Dennel04/data-acquisition-course/data-acquisition/lab2/src/README.md

# Labor 2 mõõtmistarkvara

Esimene etapp kogub ainult ADC toorandmeid. Varasema versiooni USB-only üleslaadimine, LCD töö ja `measure_stop` käsu `stopped` vastus on kasutaja kinnitatud (Serial Monitor `--eol LF`). Allpool kirjeldatud AUTO-versioon on kohalik muudatus ja vajab eraldi üleslaadimisluba ning riistvarakatset. Elektriline sobivus, tegelik sagedus ja rõhukalibratsioon vajavad mõõtmist. Labor 1 lähtekood jääb muutmata. Võrguühenduseta CSV analüüs: [notebooks/README.md](../notebooks/README.md).

- 14.11.26 märkus: ühises AtomS3R-is on praegu ajutine G5-mõõtja ([`firmware_g5meter`](firmware_g5meter/src/main.cpp)), mitte `DA2_MEASURE_V1`. Varem seadmes olnud `DA2_MEASURE_V1` salvestati enne üleslaadimist täieliku flash'i koopiana. Enne `logger.py` kasutamist pane `DA2_MEASURE_V1` tagasi. [Üksikasjad](../docs/opamp_rebuild_2026-11-14.md#3-atomi-püsivara-muutus).
- 14.11.26 märkus: ümberehitatud astme kordustest: [`opamp_retest.py`](python/opamp_retest.py), käivitus topeltklõpsuga `run_opamp_retest.bat` / `run_opamp_retest.command`. Töötab nii `DA2_MEASURE_V1` kui G5-mõõtjaga. [Juhend](../docs/opamp_retest.md).

## Mõõtmisrežiim

`firmware/` on AtomS3R PlatformIO projekt (`atoms3r`, ühilduv board `m5stack-atoms3`). GPIO G5 on sisend: 12 bitti, `ADC_11db`, kaheksa lugemi täisarvuline keskmine. Siht on üks proov iga 10 ms järel. Hilinenud ajavahemikud loendatakse, mitte ei täideta väljamõeldud proovidega.

Pärast toite sisselülitamist alustab seade AUTO-režiimis ADC lugemist ka ilma USB monitori või logijata. LCD näitab `AUTO / config unknown`, viimast ADC koodi ja `not calibrated`. LCD ja Serial Monitori eelvaade uuenevad kuni neli korda sekundis; see on kuvamise sagedus, mitte ADC 100 Hz siht. Täis USB-puhvri korral jäetakse eelvaaterida saatmata, ADC lugemine ja LCD jätkavad.

AUTO ei määra `raw/opamp` ühendust ega arvuta pinget või rõhku. Lahtise G5 kood võib ujuda. Automaatkäivitus ei kinnita ühendatud ahela elektrilist ohutust: uus versioon hakkab G5 lugema kohe pärast käivitumist, seega tuleb sisendi ohutus kontrollida enne toite sisselülitamist.

Wi-Fi, võrk, pumbajuhtimine, robot ja salvestatud seadete laadimine puuduvad. NVS-i algatamine ja namespace'ide avamine on linker-guardidega blokeeritud, et Arduino automaatne taastamine ega M5 teegid ei muudaks olemasolevaid seadeid. See ei taga kogu flash'i muutumatust: SDK panic/coredump ja OTA metadata jäävad eraldi riskiks. Ärge kasutage `erase_flash`, `uploadfs` ega tehase lähtestamist. Enne eraldi lubatud üleslaadimist kontrollige olemasoleva püsivara taastamise võimalust ja privaatset backup'i.

`raw` tähendab kontrollitud anduriväljundit, `opamp` kontrollitud astme väljundit. Silt ei muuda juhtmestikku ega kalibratsiooni. Mõlema elektriline sobivus tuleb eraldi kinnitada: [tööjärjekord](../docs/bench_session.md#6-mõõtmisprogrammi-kasutuselevõtt).

## USB protokoll

115200 baud. AUTO-eelvaade on loetav tekstirida prefiksiga `# AUTO `: aeg `t_ms`, ADC kood, `config=unknown`, `calibrated=false` ja vahele jäänud ADC intervallide arv `missed`. See ei ole CSV ega logija mõõtepakett.

Juhtkäsud ja hallatud mõõtepaketid on üks ASCII JSON-objekt real, lõpus LF (`\n`). Logija saadab ühe käivituskäsu koos juhusliku jooksu ID-ga:

```json
{"cmd":"measure_start","config":"raw","run":"0123456789abcdef"}
```

`measure_start` lülitab AUTO välja, alustab uut loendust (`seq=0`, `missed=0`) ning kinnitab `event=started`, `firmware=DA2_MEASURE_V1`, sama `run` ja `config`, `period_ms=10`, `adc_pin=5`, `adc_bits=12`, `adc_samples=8`, `calibrated=false`. Seejärel väljastab ainult hallatud mõõtepakette:

```json
{"t":1234,"adc":123,"p":null,"pump":null,"config":"raw","run":"0123456789abcdef","seq":0,"missed":0}
```

Näide on sünteetiline, mitte mõõtmine. `t` on Atomi `millis()`, `seq` algab nullist, `missed` loendab vahele jäänud 10 ms intervalle. `{"cmd":"measure_stop"}` peatab nii AUTO kui ka hallatud mõõtmise, vastab `{"event":"stopped"}` ning kuvab `STOPPED`. Uus `measure_start` saab alustada uut jooksu. Toite taaskäivitus alustab jälle AUTO-režiimist. Neid käske ei tohi asendada Labor 1 pumbakäskudega. Vigane käsk või serial-raam peatab mõõtmise. USB kadumine peatab hallatud jooksu; taasühendus seda ei taasta. AUTO jätkab ilma USB-ta LCD-l.

Kasuta AUTO-versiooniga selle repo ajakohastatud logijat: enne käivituskinnitust ignoreerib see veel puhvris olevaid AUTO-ridu. Pärast kinnitust kehtib sama range JSON-protokoll ja CSV-skeem; ükski AUTO-rida ei lähe CSV-sse. Ootamatu AUTO-rida käimasoleva jooksu sees on viga, mitte vaikselt eemaldatav proov.

## ADC vaatamine ilma logijata

Pärast eraldi lubatud AUTO-versiooni üleslaadimist piisab LCD jaoks toitest. Serial Monitoris vali 115200 baud ja LF. PlatformIO monitor Windows PowerShellis:

```powershell
pio device monitor --port COM3 --baud 115200 --eol LF --filter send_on_enter --echo
```

macOS-is:

```sh
pio device monitor --port /dev/cu.usbmodem1301 --baud 115200 --eol LF --filter send_on_enter --echo
```

Asenda port tegeliku seadme omaga. `pio` peab olema arvutisse paigaldatud; ka muu 115200 baud / LF Serial Monitor sobib. AUTO-eelvaate nägemiseks pole vaja ühtegi käsku. Peatamiseks saada `{"cmd":"measure_stop"}` ja Enter. Pärast peatamist saab uue hallatud jooksu alustada alloleva logijaga, AUTO taastub toite taaskäivitamisel.

Atom ei loo arvutis CSV-faili. AUTO tekst on vaatamiseks kuni 4 Hz, mitte 100 Hz andmestik analüüsiks. CSV ja jooksu metaandmete salvestamiseks kasuta allolevat Python logijat, sulgedes enne Serial Monitori. Logija valib ühendusele vastava `raw/opamp` sildi ja käivitab hallatud 100 Hz sihiga jooksu. Ka muu arvutiprogramm võiks andmeid salvestada, kuid monitori kopeeritud teksti ei tohi esitada selle logija CSV-na.

## Logija Windowsis ja macOS-is

Sulge Serial Monitor ja kõik teised sama porti kasutavad programmid. Kasuta tegelikult tuvastatud porti, mitte vana pordinumbrit. Järgmised käsud on tulevase füüsilise katse jaoks, mitte selle ettevalmistuse käigus tehtud katsed:

Logija lubab ainult kohalikke porte `COM1`, `COM3`, `COM10` jne (ka väiketähtedega) või macOS-i `/dev/cu.*` nimesid. URL-id ja kaugühendused on keelatud. Windowsis ei anta pyserialile POSIX-i `exclusive` parameetrit; macOS-is säilib `exclusive=True`. DTR ja RTS seatakse enne avamist väärtusele `False`. Vigane või avamatu port ei tekita CSV-d ega `.runs.jsonl` faili; olemasolev CSV säilib.

**Windows PowerShell**, repo juurkataloogist:

```powershell
cd data-acquisition/lab2
py -3 -m venv .venv
.\.venv\Scripts\python.exe -m pip install -r src/python/requirements.txt
```

Leia Atomile määratud COM-number Device Managerist (`Ports (COM & LPT)`). Järgmises käsus asenda `COM3` tegeliku pordiga. Käivita see ainult pärast ühendatud raw-ahela elektrilist kontrolli multimeetriga; `--electrical-check-confirmed` kinnitab seda kontrolli, mitte USB-only testi:

```powershell
.\.venv\Scripts\python.exe src/python/logger.py --port COM3 --config raw --csv data/measurements.csv --condition atmosphere --trial 1 --duration 10 --electrical-check-confirmed
```

**macOS**, repo juurkataloogist; asenda `/dev/cu.usbmodemXXXX` tegeliku pordiga ja kinnita enne mõõtmist sama elektriline kontroll:

```sh
cd data-acquisition/lab2
python3 -m venv .venv
.venv/bin/pip install -r src/python/requirements.txt
.venv/bin/python src/python/logger.py --port /dev/cu.usbmodemXXXX \
  --config raw --csv data/measurements.csv --condition atmosphere \
  --trial 1 --duration 10 --electrical-check-confirmed
```

Püsivas tööpunktis lisa `--dmm-v TEGELIK_PINGE` (asenda mõõdetud arvuga). See on käsitsi sisestatud G5 sõlme võrdluspinge, mitte iga proovi mõõdetud pinge. `dmm_recorded_utc` on logijasse sisestamise aeg; tegelik multimeetri mõõtmisaeg ja meetod märgi töölehele. Ära lisa üht püsipinge näitu muutuva impulsi jooksule.

Järgmise jooksu lisamiseks samasse CSV-sse kasuta `--append`, uut `--trial` numbrit ning õiget `--config raw` või `--config opamp`. Olemasolevat faili ilma `--append` parameetrita ei kirjutata üle. Ühine CSV on lubatud ainult koos iga rea `config`, `run_id`, `condition` ja `trial` väljadega. Füüsiliselt vaheta ühendusi ainult väljalülitatud toitega.

CSV veerud:

```text
t_ms,adc,p_kpa,pump,config,run_id,seq,missed,voltage_v,dmm_reference_v,dmm_recorded_utc,condition,trial,adc_clipped
```

`p_kpa`, `voltage_v` ja `pump` jäävad tühjaks: puuduvad selle seadme ja kummagi konfiguratsiooni kinnitatud teisendus ning pumba tagasiside. Tühi pump ei tähenda `off`. `adc_clipped` märgib ainult koodi 0 või 4095, mitte diagnoosi ega elektrilist ohutust. Kõik jooksud saavad kõrvalfaili `.runs.jsonl`, kus on kestus, ridade arv, sagedus, min/max intervall ja vead. Poolik jooks säilib tõendina; ära kasuta seda vaikimisi kehtiva võrdlusena. Logija lõpetab vigase raami, vale konfiguratsiooni, puuduva proovi või 500 ms vaikuse korral; pumba olekut ta ei muuda. Väljumiskood 0 nõuab lõppenud jooksu, null vahelejäänud intervalli ning 9–11 ms proovivahesid. Tegelik USB läbilase ja 100 Hz tuleb riistvaral kontrollida.

## Tarkvarakontroll

**AUTO kontrolliseis (07.11.2026): software-tested, mitte hardware-verified.** Sünteetilised tarkvaratestid: 43 läbitud, kaks muutmata analüsaatori graafikutesti jäid Matplotlibi puudumisel vahele. Hostil kontrolliti tegelikku C++ mõõtmisloogikat ja firmware loop'i imiteeritud ADC/LCD/USB-ga; `atoms3r` build õnnestus. AUTO-versiooni ei laaditud selle kontrolli käigus seadmesse ega kontrollitud füüsilisel riistvaral. Varasemad mõõtmisprotokollid ei kinnita selle AUTO-versiooni riistvarakatset.

```sh
python3 -m unittest discover -s data-acquisition/lab2/tests -v
cd data-acquisition/lab2/src/firmware
pio run -e atoms3r
```

Testid kasutavad sünteetilisi JSON-ridu, ajakella ja ajutisi CSV-faile; ühestki testist ei saa füüsilisi mõõtetulemusi. Hostil kompileeritakse ka tegelik C++ ajastusloogika. Üleslaadimine vajab eraldi luba.

## Labor 1 lähtejoon ja veel vajalik kalibratsioon

- Toetada kahte selgelt valitavat konfiguratsiooni: `raw` ja `opamp`.
- Hoida konfiguratsiooniga seotud ADC ja teisenduse seaded eraldi ning jälgitavad.
- Võtta raw-konfiguratsiooni lähtepunktiks Labori 1 MPX5700AP ülekandefunktsioon `Vout = Vcc · (0,0012858 · P_abs + 0,04)`, 12-bitine ADC, `ADC_11db`, kaheksa lugemi keskmine ja empiiriline koodist pingeks tegur `3,70 V / 4095`. Allikad: `data-acquisition/lab1/src/firmware/include/sensor.h`, `data-acquisition/lab1/src/firmware/src/sensor.cpp` ja `data-acquisition/lab1/docs/sensor_choice.md`. Kontrollida tegur Labor 2 riistvaral uuesti: TODO: real measurement required.
- Säilitada ametliku Labor 2 sisendi diskreetimise siht `100 Hz`. Laboris 1 mõõdeti `1002` rida `10010 ms` jooksul ehk ligikaudu `100,1 Hz`; Labor 2 tegelik sagedus: TODO: real measurement required.
- Kuvada konfiguratsioon nii, et logi ja ekraani olek ei läheks segamini.

## Python logger

- Lisada Labori 1 CSV-skeemile `t_ms,adc,p_kpa,pump` veerg `config`, mille lubatud väärtused on `raw` ja `opamp`.
- Säilitada ajatempel, ADC toorväärtus, suhteline rõhk kilopaskalites ja pumba olek.
- Kontrollida tegelikku diskreetimissagedust ajatemplite järgi. TODO: real measurement required.
- Tagada, et mõlema konfiguratsiooni andmeid saab võrrelda sama skeemi ja ühikutega.

## Pumbajuhtimine

Pumbajuhtimise ühendamine tuleb pärast astme ehitamist, elektrilist kontrolli ja `raw/opamp` võrdlusandmete kogumist. Labori 1 ajalooline lähtejoon oli `off −60 kPa`, `on −40 kPa`, automaatsete taaskäivituste minimaalne väljalülitusaeg `15 s` ja ülempiir `4 käivitust/min` (`data-acquisition/lab1/docs/pump_control.md`). Labor 2 väärtused määratakse uute mõõtmiste põhjal: TODO: real measurement required.
