Dennel04/data-acquisition-course/study-ru/lab2-translation.md

# Перевод Data Acquisition Lab 2

> Личный русский перевод для понимания задания. Не является официальным сдаваемым документом.
> Оригинальный эстонский текст: `study-ru/source-lab2-est.md`
> Официальный источник:
> https://github.com/KKallas/Narva-subjects/blob/main/EST/2026-27/Data%20Acquisition/Data%20Acquisition%20%5BLab%202%5D%20EST.md

## Сбор данных: Лабораторная работа 2 — Операционный усилитель, просто, но сложно

**Объём работы:** 32 часа | **Оценивание:** 20 баллов | **Команда:** 3 студента | **Выдано:** 07.10.26 | **Дата заказа:** 16.10.26 | **Первая защита:** 27.10.26, онлайн

### Как работает этот документ

* Репозиторий и порядок работы остались от Лабораторной работы 1.
* Перенеси из этого документа в репозиторий проекта то, что нужно: папку этой лабораторной, `README.md`, куда войдут ваши числа, решения и ответы KAARDISTA ISE, а также файлы из контрольного списка. Копировать весь документ не требуется.
* Схемы и симуляции добавляются в документ как изображения. Рядом с изображением добавляется ссылка на редактируемый файл, чтобы другой человек мог его открыть и продолжить работу.

### Цель

В Лабораторной работе 1 датчик подключался прямо к ADC, между ними ничего не было. Это было сделано намеренно. Теперь видно, к чему это привело.

Выход MPX5700AP во всём диапазоне насоса −70 … +110 kPa меняется в пределах 0,40 … 1,56 V. Это около трети диапазона ADC. Остальные две трети не используются, а один шаг ADC составляет около 125 Pa. Плохое измерение связано не с плохим датчиком, а с тем, что сигнал слишком мал для ADC и расположен на неподходящем уровне.

В этой лабораторной работе между датчиком и ADC добавляется каскад, который вычитает смещение и усиливает сигнал так, чтобы он заполнял диапазон ADC. Затем вы измеряете, что изменилось.

**Почему мы усиливаем сигнал, а не меняем датчик.** Правильным решением вместо неверного масштаба был бы датчик с правильным масштабом: дифференциальный датчик меньшего диапазона, выход которого уже заполняет диапазон ADC. Mouser больше не продаёт датчики этого класса (MPX5100DP): производство прекращено, а подходящей замены к нужному сроку не было. Поэтому мы остаёмся с MPX5700AP и исправляем масштаб схемой. Так происходит и в реальной работе: источник остаётся таким, какой он есть, а его недостаток компенсируется схемой. Здесь есть честное ограничение: усиление увеличивает сигнал для ADC, но не возвращает информацию, которую датчик не измерил. Эту разницу вы измерите сами.

Если в Лабораторной работе 1 ваша команда нашла другой доступный датчик, числа будут другими, а направление сигнала тоже может отличаться: датчику, выход которого доходит до 4,7 V, нужен не усилитель, а делитель. **Каскад проектируется по вашему датчику, а не по этой странице.** Числа на этой странице относятся к MPX5700AP и приведены как пример.

Самое важное: каскад не является самостоятельной целью. Он нужен из-за одной конкретной ситуации.

Присоска находится на стекле, но край остался немного открытым — захват неполный. Коробка этого не знает. Давление падает, насос запускается, достигает давления выключения, отключается, утечка сразу возвращает давление назад, и насос запускается снова. Коробка застревает в коротком цикле. Снаружи она выглядит исправной: давление находится в диапазоне, экран сообщает, что удержание работает. Но коробка не удерживает, а качает через отверстие.

Неполный захват отличается от правильного не **значением** давления. Он отличается тем, **как быстро падает давление** после выключения насоса. При правильном захвате оно падает медленно, при неполном — быстро. Эта разница теряется в сигнале Лабораторной работы 1 из-за шума и квантования: один шаг ADC равен 125 Pa, медленное падение выглядит как последовательность одинаковых чисел, и вы замечаете его только тогда, когда оно уже стало большим. После каскада шаг становится в несколько раз меньше, и то же падение видно намного раньше. Новая информация не появляется: вы получаете то, что уже было в сигнале, но оставалось скрытым.

Это важно, потому что на присоске висит поликарбонатное стекло. «Вакуум достигнут» не является достаточным решением для подъёма: это число может выглядеть безупречно за мгновение до того, как стекло отпадёт. Для подъёма нужно решение «вакуум **держится**», а удержание определяется наклоном, а не значением. В этой лабораторной работе наклон ещё не вычисляется, это работа L3. Но наклон нельзя вычислить по сигналу, в котором его не видно, а каскад делает его видимым.

В конце управление насосом из Лабораторной работы 1 запускается с новым сигналом: более узкая полоса, меньше запусков в минуту, более раннее обнаружение неполного захвата. Эти числа покажут, стоил ли каскад затраченных усилий. Может выясниться, что не стоил. Это тоже результат, если он выражен числом.

В этой лабораторной работе четыре части:

1. **Чего не хватает.** Повторно измерьте сигнал Лабораторной работы 1 и числами опишите, что должен делать каскад.
2. **Каскад.** Сначала Falstad, затем макетная плата. Рассчитайте цель, соберите и измерьте.
3. **Исправление.** Измеренное не совпадает с расчётом. Объясните причину и пересчитайте.
4. **Разница.** Один и тот же импульс через обе конфигурации, спектры рядом и управление насосом из Лабораторной работы 1 с новым сигналом.

В первый день новых деталей нет. Соберите схему из того, что есть на полке, а недостающие детали внесите в заказ, который отправляется 16.10.

*Это живой документ. Обновляйте цели, если они меняются по ходу работы: новые знания иногда делают старые цели бессмысленными. Документ должен удерживать команду на цели, чтобы она не потерялась в деталях и не оставила главную проблему нерешённой.*

**KAARDISTA ISE (заполни по своим реальным данным) — цель в том виде, какой она получилась в действительности.**

### Контрольный список

**Должно быть выполнено**

- [ ] Сигнал Лабораторной работы 1 пересчитан: Pa на один шаг ADC, процент используемого диапазона ADC и требования к каскаду.
- [ ] Схема каскада в Falstad, полученные из неё номиналы резисторов и источник шума.
- [ ] Каскад на макетной плате, измерения мультиметром в трёх точках давления, одновременное изображение входа и выхода на осциллографе.
- [ ] Отклонения первой версии на краях диапазона записаны и объяснены, каскад пересчитан, новое измерение приведено рядом со старым.
- [ ] Один и тот же импульс записан в обеих конфигурациях, спектры расположены рядом со спектрами Лабораторной работы 1.
- [ ] Pa на один шаг ADC и SNR до и после.
- [ ] Управление насосом из Лабораторной работы 1 повторно измерено с новым сигналом, новые числа добавлены под старыми в файле `docs/pump_control.md`.
- [ ] Неполный захват записан с обоими сигналами, время обнаружения указано в секундах.
- [ ] Заказ на 16.10 находится в файле `docs/bom.md`.
- [ ] Репозиторий и журнал разработки заполнены, tag `data-acquisition-lab2` создан.

**KAARDISTA ISE — даты и ваши собственные шаги.**

### Входные данные

* Из Лабораторной работы 1: макетная плата с датчиком, логгер 100 Hz, формат CSV, спектры необработанного сигнала, `pump_control.md`, `sensor_choice.md`.
* С полки: LM358N, набор резисторов и конденсаторов, вторая макетная плата, мультиметр, осциллограф.
* От преподавателя: MG400 с насосной коробкой.
* Из L2 курса 3D-печати: гнездо, в котором стекло находится в определённом положении; по нему строится кривая давления при реальном подъёме.
* Из L2 курса «Умные решения»: страница Atom, куда войдут настройки датчика и тестовая кнопка.

### Оборудование и инструменты

1. AtomS3, кабели USB-C
2. Ваш датчик из Лабораторной работы 1
3. LM358N ×5, набор резисторов и конденсаторов, две макетные платы, провода
4. Мультиметр
5. Двухканальный осциллограф
6. MG400 с насосной коробкой, шлангом, T-образным соединителем и присоской
7. Arduino IDE или PlatformIO; Python 3, pyserial, Jupyter Lab, numpy, pandas, scipy, matplotlib
8. Falstad
9. Git

*Если план меняется, обновите список оборудования или создайте схему draw.io, которая показывает взаимодействие частей системы.*

**KAARDISTA ISE — что вы использовали на практике.**

### Справочная информация

* **LM358** — операционный усилитель с однополярным питанием. Перед началом работы проверьте по datasheet, насколько близко выход может подойти к напряжению питания. При питании 5 V верхний предел выхода LM358 составляет около 3,5 V. От этого числа зависит, помещается ли ваша цель в доступный диапазон.
  [https://www.ti.com/product/LM358](https://www.ti.com/product/LM358)
* **Datasheet MPX5700AP**
  [https://www.nxp.com/docs/en/data-sheet/MPX5700.pdf](https://www.nxp.com/docs/en/data-sheet/MPX5700.pdf)
* **Falstad**
  [https://www.falstad.com/circuit/circuitjs.html](https://www.falstad.com/circuit/circuitjs.html)
* **ESP32 ADC** — диапазон, аттенюация и нелинейность в верхней части диапазона
  [https://randomnerdtutorials.com/esp32-adc-analog-read-arduino-ide/](https://randomnerdtutorials.com/esp32-adc-analog-read-arduino-ide/)
* **Как работает ADC** — короткое видео на случай, если смысл шага квантования пока неясен. Сначала посмотрите часть 1, после этого «Pa на один шаг ADC» становится простой арифметикой.
  [https://www.youtube.com/watch?v=g4BvbAKNQ90](https://www.youtube.com/watch?v=g4BvbAKNQ90)
* **Как работает операционный усилитель** — та же серия и тот же уровень. Посмотрите часть 2, чтобы треугольник в Falstad не оставался просто треугольником.
  [https://www.youtube.com/watch?v=kbVqTMy8HMg](https://www.youtube.com/watch?v=kbVqTMy8HMg)
* **Консультация по операционному усилителю** — схема смещения и масштабирования, типичные ошибки, работа с осциллографом. Время согласовывается с командами по ходу работы. Приходите с измеренными числами: «не работает» — это не вопрос, а «я рассчитал X V, измеряю Y V, вот оба значения» — вопрос.
  [Контактные занятия в паспорте курса](../../Data%20Acquisition/SVNC.00.325_SO%20EST%20v2.md#kontakttundide-ajakava)
* **scipy.fft и `scipy.signal.welch`**
  [https://docs.scipy.org/doc/scipy/reference/fft.html](https://docs.scipy.org/doc/scipy/reference/fft.html)
* **Делитель напряжения и усиление.** На двух формулах строится вся лабораторная работа. Запишите обе формулы от руки до того, как откроете Falstad. Если вы не можете самостоятельно их записать, вы не сможете определить, лжёт ли Falstad.

*Добавьте сюда источники и полезную информацию, которые помогут понять проект даже спустя годы.*

**KAARDISTA ISE — ваши источники.**

### Части работы

#### 1. Чего не хватает

Откройте CSV и спектр Лабораторной работы 1. Рассчитайте три величины: на сколько вольт меняется выход вашего датчика во всём диапазоне насоса, какой процент диапазона ADC он занимает и сколько Pa приходится на один шаг ADC.

Пример MPX5700AP. Передаточная функция: `Vout = 5 · (0,0012858 · P + 0,04)`, где P — абсолютное давление в kPa. Давление насоса −70 kPa соответствует абсолютному давлению 31 kPa, а +110 kPa — 211 kPa, поэтому выход меняется от 0,40 V до 1,56 V. Диапазон составляет 1,16 V. Шаг ADC равен 3,3 V / 4096 ≈ 0,81 mV. Чувствительность датчика равна 5 · 0,0012858 ≈ 6,43 mV/kPa. Таким образом, один шаг ADC составляет около 0,81 / 6,43 ≈ 0,125 kPa, то есть 125 Pa.

Здесь есть два разных числа, описывающих «неиспользуемую» часть, и оба верны, но означают разные вещи:

* Из **шкалы датчика** используется около четверти: 180 kPa из 700. В этой лабораторной работе это не исправляется. Это следствие выбора датчика, и оно останется до замены датчика.
* Из **диапазона ADC** используется около трети: 1,16 V из 3,3. **Это исправляет каскад.**

Укажите оба числа и не смешивайте их. В этой работе вы исправляете только второе.

Теперь примите решение. Что должен делать каскад? Если выход мал, уберите смещение и добавьте усиление. Если выход превышает 3,3 V, используйте делитель. Учтите, что делитель делит сигнал и шум с одинаковым коэффициентом, поэтому их отношение не меняется. Делитель защищает вывод ADC, но не улучшает измерение. Усиление работает иначе.

Коэффициент усиления определяется требованием преобразовать диапазон датчика в диапазон ADC. Не нацеливайтесь точно на ноль: оставьте небольшой запас внизу, потому что ADC нелинеен в самой нижней части диапазона. Первая цель: **0,2 … 3,3 V**, то есть диапазон 3,1 V. Для MPX5700AP коэффициент усиления равен 3,1 / 1,16 ≈ 2,7.

Верхний край: операционный усилитель питается от 5 V, а выход LM358 остаётся примерно на 1,5 V ниже верхней шины, то есть достигает ~3,5 V. Значение 3,3 V помещается ниже этого предела. Проверьте число по своему datasheet: если операционный усилитель питается от 3,3 V, ограничение задаёт шина питания, и цель должна быть ниже.

На этом расчёт закончен. Удержится ли эта цель на макетной плате, спрашивает часть 2, а часть 3 даёт ответ. Не забегайте вперёд.

Запишите: диапазон выходного напряжения датчика; процент занимаемого диапазона ADC; текущее количество Pa на один шаг ADC; требуемое действие каскада, целевой диапазон и коэффициент усиления. Если ваш датчик отличается от MPX5700AP, возьмите те же величины из datasheet своего датчика.

#### 2. Каскад, первая версия

Если схема не работает в Falstad, она не будет работать и на макетной плате.

Датчик представлен в Falstad источником напряжения с его диапазоном. Один вход каскада получает сигнал датчика, второй — опорное напряжение. Выход должен составлять 0,2 V, когда датчик находится на нижнем краю, и 3,3 V, когда он находится на верхнем краю. Два условия дают два уравнения. Номиналы резисторов и опорное напряжение выводятся из них, а не подбираются догадками.

Обратите внимание: опорное напряжение не равно нижнему выходному напряжению датчика. Оно находится ниже ровно настолько, чтобы выход пришёл к 0,2 V, а не к нулю. Если забыть эту разницу, вся кривая сместится.

Затем выполните действие, которое показывает назначение операционного усилителя. Добавьте источник шума в общую землю обоих входов и посмотрите, что происходит на выходе. Затем подключите тот же источник шума только к одному входу и повторите наблюдение. В первом случае шум в основном исчезнет, во втором пройдёт с усилением. Запишите, во сколько раз отличаются результаты.

После этого переходите к макетной плате. Питание 5 V. Измерьте его мультиметром и запишите. USB «5 V» не всегда равно 5,00 V. Это число понадобится в части 3.

Сначала мультиметр, потом Atom. Измерьте выход каскада в трёх точках давления: атмосфера, полное всасывание, полное нагнетание. Для каждого измерения укажите расчётное значение и разницу.

Теперь выполните главную часть этого этапа: **пока ничего не исправляйте.** Рассмотрите края отдельно. Даёт ли полное всасывание реальные 0,2 V или выход где-то застревает? Даёт ли полное нагнетание 3,3 V или меньше? Если разница превышает несколько процентов, не меняйте резисторы: запишите число и переходите к части 3. Причина этой разницы и есть то, чему учит лабораторная работа. Вы не увидите её, если исправите схему до записи результата.

Используйте два канала осциллографа: выход датчика и выход каскада на одном импульсе, одно изображение. Проверьте форму вершины выхода: она округлая, как на входе, или плоская? Плоская вершина даёт ответ.

Запишите: номиналы резисторов и опорное напряжение, а также способ их расчёта; экспорт Falstad и изображение в документе со ссылкой на редактируемый файл; разницу между шумом в общей земле и на одном входе; измеренное напряжение питания; измеренное напряжение в трёх точках давления рядом с расчётным и отдельную разницу для обоих краёв; изображение осциллографа.

#### 3. Исправление

После записи чисел требуется объяснение. Есть три причины, по которым каскад не дал результат, обещанный расчётом.

**Верхний край.** LM358 не является rail-to-rail. При питании 5 V выход остаётся примерно на 1,5 V ниже верхней шины, то есть достигает ~3,5 V. Но ваше питание не равно 5,00 V: USB часто даёт 4,75 V, и тогда потолок равен 3,25 V. Ваша цель была 3,3 V. Она не могла поместиться в доступный диапазон. Плоская вершина не означает, что давление перестало расти. Она означает, что операционный усилитель перестал следовать за входом.

**Нижний край.** На другом краю возникает похожая, но менее очевидная проблема. Datasheet утверждает, что выход доходит до нескольких милливольт от земли, и это верно в режиме *насыщения*. В линейном режиме это неверно. Выходной каскад LM358 хуже всего работает в последних нескольких сотнях милливольт: подтягивание вниз слабое, и управление переходит от одного транзистора к другому. Ваши 0,2 V находятся как раз в этой области. Выход показывает некоторое число, но оно больше не связано с сигналом датчика линейно. Эта ошибка хуже плоской вершины, потому что внешне значение не выглядит неправильным.

**И сам ADC.** ADC ESP32 нелинеен на обоих краях: внизу около 0,1 V, наверху ещё до 3,3 V. Даже с идеальным операционным усилителем не стоит целиться точно в края.

**Почему Falstad этого не показал.** Операционный усилитель Falstad является идеальной моделью. Он насыщается у шин питания и не сообщает ничего сверх этого. В модели нет кроссоверных искажений, слабого подтягивания вниз и реального напряжения питания. Симуляция не солгала: она не знает того, что вы ей не задали. Запишите эту фразу в журнал разработки; она относится к любой симуляции, которую вы ещё выполните в этой учебной программе.

Теперь пересчитайте схему. Новые цели: **0,3 V на нижнем краю и 3,0 V на верхнем**, то есть диапазон 2,7 V. Для MPX5700AP коэффициент усиления равен 2,7 / 1,16 ≈ 2,3. Опорное напряжение вычисляется так же, как раньше, но для 0,3 V. Если измеренное питание оказалось заметно ниже 5 V, рассчитайте верхнюю цель по измеренному питанию, а не по надписи.

Если эта часть остаётся непонятной, не работайте в одиночку: консультация по операционному усилителю предназначена именно для этого, а измерения части 2 будут лучшим материалом для консультации. Время согласуют, когда команда дойдёт до этого этапа.

При этом теряется 18% диапазона ADC. Взамен измерение остаётся линейным на обоих краях. Плоский или искривлённый край не является измерением: он даёт ноль информации и неверное число. Потеря 18% за это невелика.

Замените резисторы, повторно измерьте те же три давления и поместите новые числа рядом со старыми. Теперь измеренное должно совпасть с расчётным во всех трёх точках. Если совпадения нет, найдите другую неисправность до продолжения работы. В части 4 записывается исправленный каскад, а не первая версия.

Запишите: новые резисторы, опорное напряжение и коэффициент усиления; измеренные значения в трёх точках рядом с расчётными и рядом с числами первой версии; отклонение первой версии на каждом краю в милливольтах; одно предложение о том, как вы в дальнейшем выбираете целевой диапазон операционного усилителя и на каких данных основываете выбор.

#### 4. Разница

Логгер получает в CSV столбец `config` со значениями `raw` и `opamp`. Схема Лабораторной работы 1 не разбирается: сравнение возможно только тогда, когда обе конфигурации существуют одновременно и один импульс одного дня проходит через обе.

Один и тот же импульс насоса, не менее 30 раз в каждой конфигурации, один CSV.

Разместите спектры рядом со спектрами Лабораторной работы 1, используйте одинаковые оси и kPa. Пики Лабораторной работы 1 уже имеют названия. Проверьте, какие пики сохранились и какие изменились. Учтите: усиление поднимает и пики. Пик, ставший в два раза выше, не является новым источником шума. Это старый источник, который теперь виден лучше.

Затем ответьте на вопрос, ради которого существует эта часть. Усиление увеличивает и собственный шум датчика. Оно уменьшает влияние шага ADC, что показывает число Pa на один шаг. Шум датчика оно не уменьшает. **Улучшился ли SNR или улучшилось только разрешение?** Ответьте числом, а не мнением. Сигнал равен среднему плато минус среднее базовой линии, шум равен стандартному отклонению плато, обе величины выражаются в kPa.

В конце выполните главную задачу лабораторной работы. Запустите управление насосом из Лабораторной работы 1 с новым сигналом. Используйте те же три ситуации, что и в Лабораторной работе 1: присоска на стекле, присоска в воздухе, шланг с заглушкой. Можно ли сузить полосу? Уменьшилось ли число запусков в минуту? Продолжает ли присоска в воздухе попадать в короткие циклы?

Затем добавьте четвёртую ситуацию, которой не было в Лабораторной работе 1: **неполный захват**. Положите присоску на стекло так, чтобы край оставался открытым: немного за краем стекла или с тонкой полоской клейкой ленты под присоской. Дождитесь выключения насоса и записывайте падение как обычно. Выполните опыт дважды, с необработанным сигналом и с каскадом, и ответьте на один вопрос: **сколько секунд проходит до того, как неполный захват можно отличить от правильного?** Укажите секунды для обеих конфигураций. Это число выражает смысл всей лабораторной работы.

Новые числа добавляются в `docs/pump_control.md` под старыми, с датой. Старые данные не удаляются. Если полоса стала уже, но насос теперь запускается чаще, вы улучшили одно и ухудшили другое. Запишите оба результата и объясните, какой из них для вас важнее.

Запишите: Pa на один шаг ADC до и после; SNR в dB до и после; изменения в спектре; новую полосу, минимальное время выключения и число запусков в минуту в трёх ситуациях рядом со старыми значениями; время обнаружения неполного захвата в секундах для обоих сигналов; одно предложение о том, стоил ли каскад затраченных усилий и на каких данных основан вывод.

**KAARDISTA ISE — ответы.** Для каждой части: числа, единицы и путь к файлу. Для невыполненного пункта одна строка с причиной.

### Безопасность

* Отключите USB и 5 V перед перемещением проводов.
* **Вывод ADC не выдерживает 5 V.** Каскад питается от 5 V, и при ошибке его выход может подняться выше 3,3 V. Проверьте выход мультиметром до подключения к Atom и повторяйте проверку после каждой замены резистора. Это единственное место в этой лабораторной работе, где оборудование можно повредить.
* Насосная коробка использует 24 V. Подключайте линии DO, когда робот отключён, а коробка отсоединена от электросети.
* Двигатель насоса не рассчитан на запуск каждую секунду. При сужении полосы следите за числом запусков в минуту. Если коробка стала теплее руки, расширьте полосу.
* Открытый шланг при +110 kPa может отлететь; не направляйте его на людей.
* Проверяйте неполный захват на столе, а не на конце робота, и не держите руку под стеклом. Неполный захват создаётся так, чтобы стекло упало: в этом состоит смысл испытания.
* Робот: не держите руки на столе, когда робот включён. Первый запуск выполняйте медленно, аварийная кнопка должна быть под рукой.
* В этой лабораторной работе пайка не используется.

### Компоненты для этой лабораторной работы

Заказ отправляется 16.10.26 и прибывает до защиты. Готового списка нет: команда сама составляет заказ в файле `docs/bom.md`, указывая для каждой строки одним предложением, какая деталь или какое число обосновывает запрос.

Заказ оформляется в общей таблице: [https://moodle.ut.ee/mod/url/view.php?id=1535601](https://moodle.ut.ee/mod/url/view.php?id=1535601). Добавьте свои строки до даты заказа; того, чего нет в таблице, не закажут. Файл `docs/bom.md` остаётся в репозитории как обоснование запроса этих деталей.

Продумайте, например: есть ли операционные усилители и запасной экземпляр, поскольку один может выйти из строя; содержит ли набор резисторов номиналы, требуемые вашим расчётом, или их придётся составлять из двух; будет ли подстроечный резистор разумнее двух постоянных и чем придётся за это заплатить; достаточно ли резисторов для одного пересчёта и перестройки каскада; поможет ли вторая макетная плата сохранить схему Лабораторной работы 1.

### Критерии оценивания

| Категория | Баллы |
| :--- | :--- |
| Рабочие файлы — прошивка Atom с обеими конфигурациями, логгер со столбцом `config`, файлы CSV | 5 p |
| Анализ — Pa на один шаг до и после, спектры рядом, SNR, новые параметры управления насосом | 5 p |
| Прототип — каскад на плате измерен в трёх точках давления до и после исправления, итоговый выход линеен на обоих краях и во всех трёх точках соответствует расчёту, управление насосом работает с новым сигналом | 5 p |
| Документация — README, журнал разработки, экспорт Falstad, обновлённый `pump_control.md`, `bom.md`, AGENTS.md | 5 p |
| **Итого** | **20 p** |

### Защита

Ссылка на git-репозиторий, tag `data-acquisition-lab2`.

Защита проходит как простой устный разговор продолжительностью 15 минут. Вы одновременно показываете на осциллографе выход датчика и выход каскада для одного импульса, на первой версии объясняете место и причину отказа, показываете остановку насоса с новым сигналом и открываете журнал разработки. Преподаватель задаёт около пяти вопросов о том, как вы выполнили работу. Если первая попытка не удалась, вы приходите снова.

В репозитории, в папке `data-acquisition/lab2/`, находятся: `src/` с прошивкой и логгером, `data/` с файлами CSV, `notebooks/` со спектрами и SNR, `docs/` с фотографией схемы, изображениями осциллографа, экспортом Falstad, `pump_control.md` и `bom.md`, `README.md` этой лабораторной работы и обновлённый `AGENTS.md`.

### Журнал разработки

**KAARDISTA ISE — журнал.** Одна запись для каждой рабочей сессии, написанная для себя так, чтобы человек, которого там не было, понял происходившее. Записи добавляются, а не изменяются.

Прилагательные не являются результатами. «Датчик был шумным» ничего не говорит; «±14 LSB в покое, ±40 LSB во время работы насосной коробки» является записью.

**PP.KK.AA — кто присутствовал**
* Сделали:
* Произошло (числа):
* Решили и почему:
* Открыто для следующего раза:

### Выходы и результаты

**Выходы**
* L2 курса «Умные решения»: константы и настройки калибровки датчика, которые войдут на страницу Atom.
* L2 курса 3D-печати: кривая давления реального подъёма показывает, удерживает ли гнездо стекло там, где его ожидает робот.
* L3 курса сбора данных: каскад, поверх которого будут построены фильтр и производная.

**KAARDISTA ISE, в конце.**
* Git-репозиторий и tag:
* Числа, полученные в этой лабораторной работе, с единицами:
* Что мы сделали бы иначе:
* Что следующая лабораторная работа должна знать до начала:

### Обратная связь
