Dennel04/data-acquisition-course/study-ru/lab1-translation.md

# Сбор данных (Andmehõive): Лаба 1 — Датчик и компрессор, который сам останавливается

> Личный перевод для понимания. Не часть сдаваемой работы — официальный документ на эстонском лежит в `data-acquisition/lab1/README.md`.

**Объём работы:** 32 часа | **Оценка:** 20 баллов | **Команда:** 3 студента | **Выдано:** 12.09.26 | **Дата заказа:** 22.09.26 | **Первая защита:** 06.10.26, онлайн

### Как работает этот документ

* Скопируй этот файл в первый день в `README.md` папки лабы в своём репо и заполняй его по ходу работы.
* Разделы «ЗАПОЛНИ САМ» пустые, потому что ответа пока никто не знает. Ты сам измеряешь и записываешь число и причину.
* Ничего не удаляется. Неверное число остаётся, с датой, исправление пишется под ним.
* Пиши так, чтобы напарник, которого не было в комнате в этот день, понял: настоящие имена файлов, настоящие числа, единицы измерения.
* Схемы и симуляции идут в документ картинкой, рядом — ссылка на живой файл, чтобы другой мог его открыть и доработать. Примеры: в разделе 2 симуляция Falstad, в разделе 3 схема draw.io. Сделай свои такими же инструментами.
* Дедлайн не важен. Важно, чтобы дело было сделано и ты понимал, что делаешь. Не получилось с первого раза — приходи завтра и пробуй снова. Защищаться можно сколько угодно раз.

### Цель

В лаборатории пять MG400 и пять коробок с насосом (pump box). Одна из них умная: измеряет давление и останавливает насос, когда давление достигнуто. Остальные четыре работают, пока включена DO-линия, независимо от того, что происходит в трубке. Все пять должны вести себя как умная. Для этого в каждую выходную трубку идёт свой датчик, на экран AtomS3 — давление и решение, а на компьютер — Python, который читает Atom по UART-USB и включает/выключает насос через DO-линию MG400. К концу года эта логика переедет на печатную плату инструмента. Сейчас она на макетной плате, где ошибка стоит одного провода. Одна и та же команда делает все три предмета: тот же Atom отправляет и букву, которую рисует робот. Три предмета, одна демонстрация: **нажал букву — робот её нарисовал.**

В этой лабе три части:

1. **Датчик.** Насосная коробка выдаёт от −70 до +110 кПа. Выбери датчик, который видит оба знака, и обоснуй выбор числами. В первый день доступен MPX5700AP из коробки старых деталей.
2. **Умная коробка.** Залогируй заводскую умную коробку, прежде чем проектировать свою. Две точки переключения и время цикла.
3. **Своя коробка.** Atom решает, экран показывает, компьютер включает/выключает. Насос сам останавливается при всасывании и выдуве, и робот берёт этим стакан.

Первым делом — заказ. В первый день новых деталей нет: продумай, что вообще нужно этой лабе и чего не хватает на полке, и оформи это заказом, который уйдёт 22.09. Заказанное придёт во время этой лабы. Пока строй из того, что есть на полке.

*Это живой документ. Обновляй цели, если они меняются по ходу работы — новые знания иногда делают старые цели бессмысленными. Смысл — держать команду в курсе цели всё время, чтобы не заблудиться в деталях и не оставить основную проблему нерешённой.*

**ЗАПОЛНИ САМ — цель такой, какой она получилась на самом деле.**

### Чек-лист

**Должно быть сделано**

- [ ] Заказ на 22.09: чего не хватает на полке для этой лабы, выбор датчика с числами.
- [ ] MPX5700AP на макетной плате, Atom показывает кПа, логгер пишет CSV на 100 Гц.
- [ ] Есть лог умной коробки, известны две точки переключения.
- [ ] Твоя коробка сама останавливается при всасывании и выдуве. USB выключен — насос выключен.
- [ ] Буква: кнопка выбирает букву, Atom отправляет её на станцию.
- [ ] Репозиторий и дневник разработки заполнены, тег `data-acquisition-lab1`.

**ЗАПОЛНИ САМ — даты и твои собственные шаги.**

### Входные данные

* С полки: AtomS3, MPX5700AP, макетная плата, набор пассивных компонентов, мультиметр, осциллограф, трубка 4 мм, тройник, заглушка для трубки, присоска, поликарбонатное стекло.
* От преподавателя: MG400 со своей насосной коробкой, заводская умная коробка по очереди, базовый Python-пакет для MG400 с включением/выключением DO: [KKallas/mg400-base](https://github.com/KKallas/mg400-base).
* Nutikad Lahendused («Умные решения») Л1: канал для буквы, согласуется в первую неделю.

### Инструменты/материалы

1. AtomS3 ×2, кабели USB-C
2. MPX5700AP; выбранный тобой датчик, когда придёт заказ
3. Макетная плата, провода, набор резисторов и конденсаторов, мультиметр
4. Осциллограф с функцией FFT
5. Трубка 4 мм, тройник, заглушка для трубки, присоска φ13 или φ16, стекло 24 × 24 мм
6. MG400 с насосной коробкой и базовым пакетом
7. Arduino IDE или PlatformIO для ESP32; Python 3, pyserial, Jupyter Lab, numpy, pandas, scipy, matplotlib
8. Симулятор схем Falstad, draw.io для схем
9. Git, один репозиторий на команду, `AGENTS.md` в корневой папке

*Если план меняется — обнови и список инструментов, или сделай схему в draw.io, показывающую, как всё работает вместе.*

**ЗАПОЛНИ САМ — что реально использовал.**

### Справочная информация

* **AtomS3**: пины, ADC-пины, экран, кнопка — [https://docs.m5stack.com/en/core/AtomS3](https://docs.m5stack.com/en/core/AtomS3)
* **ESP32 ADC и UART в Arduino**
  [https://randomnerdtutorials.com/esp32-adc-analog-read-arduino-ide/](https://randomnerdtutorials.com/esp32-adc-analog-read-arduino-ide/)
  [https://randomnerdtutorials.com/esp32-uart-communication-serial-arduino/](https://randomnerdtutorials.com/esp32-uart-communication-serial-arduino/)
* **pyserial**, сторона компьютера — [https://pyserial.readthedocs.io/](https://pyserial.readthedocs.io/)
* **Датчики**
  MPX5700AP: [https://www.nxp.com/docs/en/data-sheet/MPX5700.pdf](https://www.nxp.com/docs/en/data-sheet/MPX5700.pdf)
  MPX5100DP: [https://www.nxp.com/docs/en/data-sheet/MPX5100.pdf](https://www.nxp.com/docs/en/data-sheet/MPX5100.pdf)
  Буквы в названиях серии NXP MPX: AP — абсолютный, GP — манометрический (избыточное давление), DP — дифференциальный, V — вакуумный. Абсолютный датчик видит оба знака, манометрический — только один.
* **Насосная коробка**: ищи фразу «Dobot MG400 vacuum pump box IO control». Две DO-линии; клеммы — по инструкции.
* **Как работает реле давления компрессора**: ищи фразу «compressor pressure switch cut-in cut-out hysteresis short cycling».
* **Falstad**: [https://www.falstad.com/circuit/circuitjs.html](https://www.falstad.com/circuit/circuitjs.html)
* **Fourier**: [https://docs.scipy.org/doc/scipy/reference/fft.html](https://docs.scipy.org/doc/scipy/reference/fft.html) и `scipy.signal.welch`

*Добавляй сюда свои источники и полезную инфу, которая поможет понять проект и годы спустя, если откроешь его снова.*

**ЗАПОЛНИ САМ — твои источники.**

### Части задания

#### 1. Что заказывать

Это идёт перед постройкой. Пройдись по лабе на бумаге и продумай, что вообще нужно заказать. По каждой части: что она требует, что есть на полке, чего не хватает. Недостающее идёт в заказ.

Главный вопрос — датчик. Кандидаты: один абсолютный датчик со шкалой 30–210 кПа; два манометрических датчика, один на плюс, один на вакуум; или остаться на MPX5700AP. По каждому кандидату из даташита — одни и те же числа: чувствительность мВ/кПа, Па на один шаг АЦП, использование шкалы в процентах, выход относительно 3,3 В. Нулевой результат — тоже результат: если MPX5700AP достаточен для этой работы, напиши это с числами.

Когда в разделе 2 измерен шум, а в разделе 4 известна полоса — добавь в таблицу полосу, делённую на шум. Полоса должна быть выражена в шуме кратно (разах), а не в процентах. Если выбор из-за этого меняется — запиши это с датой под старым решением.

Записать: таблицу и решение в файл `docs/sensor_choice.md`; заказ в виде кодов деталей Mouser в файл `docs/bom.md` к 22.09, к каждой строке — одна фраза, какая деталь или число её требует.

#### 2. Датчик и первый сигнал

MPX5700AP на макетной плате: 5 В, GND, Vout → пин АЦП. Датчик напрямую в АЦП, между ними ничего нет: ни делителя, ни ОУ, ни фильтра. Это намеренно. Лаба 2 добавит сначала делитель, потом ОУ, и сравнит четыре спектра. Сравнение существует только если сырой сигнал измерен и сохранён здесь. Мультиметром — до подключения к Atom: питание 5 В, Vout на атмосфере около 0,85 В. На Atom каждые 10 мс: читать АЦП → кПа → на экран → одна строка в UART. На компьютере Python пишет CSV со столбцами `t_ms, adc, p_kpa, pump`. Проверка: лог за 10 с — это 1000 ± 5 строк, и АЦП совпадает с мультиметром в пределах 2%.

MPX5700AP не той шкалы, но абсолютный, и атмосфера — внутри его шкалы: −70 кПа это 31 кПа абсолютного давления, +110 кПа — 211 кПа, выход 0,40–1,56 В. Весь диапазон насоса — 26% его шкалы, около 125 Па на один шаг АЦП. Передаточная функция: `Vout = 5 · (0.0012858 · P + 0.04)`, P — абсолютное давление в кПа.

Записать: Па на один шаг АЦП, шум в LSB при выключенном и включённом насосе, пики спектра с названиями (мотор насоса, сервоприводы MG400, USB-питание, 50 Гц), минимум два из них подтверждены выключением источника. Схема в Falstad: датчик → АЦП с источником шума, симулированный шум против измеренного.

Стартовая точка в Falstad: датчик — источник переменного напряжения 0,2–5 В, вход АЦП смоделирован повторителем, который отсекает всё вне диапазона 0–3,3 В. Это модель АЦП, а не ступень усиления сигнала. Осциллограф на пине АЦП показывает, где сигнал обрезается. Добавь к этому свой источник шума. [Открыть симуляцию](https://www.falstad.com/circuit/circuitjs.html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)

Falstad: датчик 0,2–5 В → модель АЦП 0–3,3 В

#### 3. Умная коробка

Тройник — в выходную трубку заводской умной коробки, присоска на конце, присоска на стекле. Насос на всасывание из CLI базового пакета. Логировать пять минут.

Записать: давление выключения, давление включения, время работы насоса, время простоя, число включений в минуту. Эти пять чисел — целевые показатели для твоей коробки.

Как всё работает вместе: компьютер, робот, насосная коробка, датчик, Atom и захват. [Открыть схему draw.io](https://drive.google.com/file/d/1YczRgRYat7b16Y7tdC8Wtg52FTfknlgd/view?usp=sharing)

draw.io: компьютер, MG400, насосная коробка, датчик, AtomS3, захват

#### 4. Своя коробка

Тот же тройник — в трубку обычной коробки твоей команды. Atom получает от компьютера режим и полосу, решает сам и показывает на экране давление, режим и решение. Компьютер пишет каждую строку в CSV и переключает DO-линию по решению. Если за 500 мс строка не пришла — DO выключается. Безопасное состояние простое: если что-то не так, насос останавливается.

```
Atom → компьютер:  {"t":123456,"adc":2011,"p":-52.3,"mode":"suction","pump":1}
компьютер → Atom:  {"cmd":"mode","mode":"suction"}   {"cmd":"band","on":-40,"off":-60}   {"cmd":"stop"}
```
```
каждые 10 мс: читать АЦП → кПа → на экран → строка в UART
всасывание: если p слабее давления включения и время простоя ≥ нижний предел → насос 1
            если p сильнее давления выключения → насос 0
выдув: то же самое, с другим знаком
off, показание вне шкалы, число включений в минуту сверх предела → насос 0, причина на экране
```

Удержание: насос выключается при давлении выключения, логировать падение давления до давления включения. Три ситуации: присоска на стекле, присоска в воздухе, трубка с заглушкой. Отсюда берутся ширина полосы, нижний предел времени простоя и верхний предел включений. Присоска в воздухе не должна уходить в короткие циклы: коробка, которая включается каждую секунду, не умная, она сломана.

Взятие: робот подводит присоску к стеклу, всасывание, подъём, перемещение, выдув, отпускание. Десять раз.

Записать: полосу, нижний предел времени простоя, число включений в минуту в трёх ситуациях, давление на присоске на стекле и в воздухе, рабочий цикл насоса за десять взятий. Всё вместе с логикой — в файл `docs/pump_control.md`. Станция примет их как есть.

#### 5. Буква

Короткое нажатие пролистывает алфавит, длинное нажатие отправляет `{"letter":"A"}` в канал, согласованный с «Умными решениями». Станция читает, робот рисует.

**ЗАПОЛНИ САМ — ответы.** По каждой части: числа, единицы измерения, где лежит файл. По несделанному — одна строка, почему.

### Безопасность

* USB и 5 В выключены, прежде чем двигать провод. Пины — по даташиту. Пин АЦП не выдерживает 5 В; датчик с выходом до 4,7 В нельзя подавать на полную шкалу прямо в пин.
* Насосная коробка — 24 В. DO-линии подключаются, когда робот отключён, а коробка обесточена.
* Мотор насоса не рассчитан на включение каждую секунду. Нижний предел времени простоя — прежде чем сужать полосу. Если коробка теплее руки — расширь полосу.
* Открытая трубка при +110 кПа может «выстрелить» — не направляй её на людей. Присоска при −70 кПа не липнет к коже.
* Робот: руки не на столе, пока робот включён. Первый прогон — медленно, аварийный стоп в пределах досягаемости.
* В этой лабе не паяют.

### Комплектующие для этой лабы

Заказ уходит 22.09.26 и приходит до защиты. Готового списка нет: команда сама составляет заказ на основе части 1. Подумай, например, остаётся ли MPX5700AP или нужен новый датчик, и нужен ли запасной, и хватит ли фитингов и заглушек для трубки.

### Критерии оценки

| Категория | Баллы |
| :--- | :--- |
| Рабочие файлы — прошивка Atom, Python-логгер и управление насосом, CSV-файлы | 5 |
| Анализ — Па на шаг АЦП, спектры с подписями, числа умной коробки, кривые удержания, выбор датчика | 5 |
| Прототип — твоя коробка сама останавливается при всасывании и выдуве, USB выкл = насос выкл, робот берёт стакан, буква доходит до станции | 5 |
| Документация — README, дневник разработки, `pump_control.md`, `sensor_choice.md`, `bom.md`, AGENTS.md | 5 |
| **Итого** | **20** |

### Защита

Ссылка на git-репо, тег `data-acquisition-lab1`.

Защита — простой устный разговор на 15 минут. Показываешь, как твоя коробка сама останавливается и снова включается, когда поднимаешь присоску, и открываешь свой дневник разработки. Преподаватель задаёт около пяти вопросов о том, как ты это сделал. Не получилось с первого раза — приходишь снова.

В репо, в папке `data-acquisition/lab1/`: `src/` — прошивка и логгер, `data/` — CSV-файлы, `notebooks/` — спектры, `docs/` — фото схемы, фото с осциллографа, экспорт из Falstad и три md-файла, этот файл как `README.md`, и обновлённый `AGENTS.md`.

### Дневник разработки

**ЗАПОЛНИ САМ — дневник.** Одна запись за каждую рабочую сессию, написанная для себя же, так, чтобы человек, которого там не было, понял. Записи добавляются, не редактируются.

**ДД.ММ.ГГ — кто присутствовал**
* Сделали:
* Что произошло (числа):
* Решили, и почему:
* Осталось на следующий раз:

### Результаты и выходы

**Что уходит дальше**
* Nutikad Lahendused Л1: буква на станцию; логика управления насосом и точки переключения в файле `docs/pump_control.md`.
* Andmehõive Л2: макетная плата, логгер на 100 Гц, формат CSV, первые спектры с сырым сигналом, с которыми сравнят делитель и ОУ.
* Andmehõive Л3: та же логика, переезжающая на плату инструмента.

**ЗАПОЛНИ САМ, в конце.**
* Git-репо и тег:
* Числа, которые дала эта лаба, с единицами измерения:
* Что бы сделали иначе:
* Что следующая лаба должна знать перед началом:

### Обратная связь
