Dennel04/data-acquisition-course/data-acquisition/lab3/docs/bench_session.md

# Labor 3 esimese füüsilise päeva kontrollleht

Täita päris komponentide juures. See leht ei kinnita saadavust ega ühtegi läbiviidud katset. [Ametlik ülesanne](../assignment-EST.md) ja [BOM](bom.md) eristavad nõutavat ning tegelikult kontrollitut.

## Klapp ja relee

- Klapi täpne märgistus, nimipinge ja vool: **TODO**
- M5Stack Mini 3A Relay Unit ning relee enda markeering/andmeleht: **TODO**
- Loogikapoole toide, signaali sobivus ja GPIO: **TODO: kontrollitud allikad**
- Eraldi klapi jõuahel ja Atomi loogikaahel, ühendusskeem: **TODO**
- COM/ON/OFF tegelik ühendus vooluta ja lülitatult; NO/NC multimeetriga: **TODO**
- Induktiivkoormuse lubatud DC-pinge/vool ja varu: **TODO**
- Kaitsedioodi markeering, polaarsus (katood plussi poole) ja taluvus: **TODO**
- Pumba Y1 haru otse napale; ainult süstal läbi 3/2 klapi: **TODO: füüsiliselt kontrollida**
- Voolu all pump → süstal; vooluta süstal → atmosfäär, pump lahutatud: **TODO**
- Süstlaharu rõhk Atomi/toite väljalülitamisel ja rõhu vabanemise mõõtetõend: **TODO: kPa, päris mõõtmine**
- Klapi elektrilise ühendusskeemi pildi failitee: **TODO: lisada pärast pildi loomist**
- Füüsilise ahela foto failitee: **TODO: lisada pärast foto tegemist**
- Teine Y rõhuandurile, asukoha kandidaadid ja valiku kompromiss: **TODO**
- Lahtise napaga doseerimisrõhk ja väljalülitusrõhuni jõudmine: **TODO**
- Nõelventiili vajadus ning mõju imemisele: **TODO: ainult mõõtmise järel**

## Inventuur ja UV

- Süstla Metcal 910-B 10 cc tegelik märgistus, kolb ja kork; õppejõu täidetud vaik: **TODO**
- Otsikute suurused/kogused ja otsikukorgid: **TODO**
- Meeskonna LED/draiveri valik, sobivus ja saabumine: **TODO**
- Must kate, valguslekke kontroll, kaitseprillid 405 nm: **TODO**
- Draiveri kaudu LED-i auto-off ja vooluta väljasolek: **TODO**
- Üks eraldi valmistatav ja märgistatud kinnine otsik: **TODO: ohutu protseduur**
- Nitriilkindad, IPA, paber ja vaigu ohutusinfo: **TODO**

## Analoogahel ja toited

- Lab 2 lõplik skeem, toited, kalibratsioon ja kogu ADC ulatuse kontroll: **TODO**
- LM358N täpne markeering ja teise kanali praegune puhvriülesanne: **TODO: kontrollida enne komparaatoriks muutmist**
- Komparaatori kõrge/madal väljund ja üleminekud enne Atomi ühendamist: **TODO: V**
- Vajalik sobitus/jagur, kontrollitud IRQ-viigu lubatud pinge: **TODO**
- Anduri ning komparaatori toiterööpad ja ühine referentsmaa: **TODO**

## Kaamera, plaat, vahetükid ja mudel

- XIAO ESP32S3 Sense kaamera, töökõrgus, fookus, ristsuund ja valgus: **TODO**
- Seansi skaala mm/pixel, väikseima tilga läbimõõt px, skaala foto: **TODO**
- Valge PLA V2 on prinditud. Kas 5 × 5 võrgu samm on suurem kui suurim laik: **TODO**.
- Plaadi ja maketi CAD-lähtefail ning STL: [labori README](../README.md#nõutavad-väljundid).
- Esimese V2 kolm klaasituge mõõdeti 0,6 mm kõrguseks. Mõõtemeetod ja teise V2 kontroll: **TODO**. [Mõõteleht](../tilgaplaat/measurements.md).
- Päris AtomS3 korpuse välismõõdud, ekraani ava suurus/asukoht, raam ning ekraani sügavus: **TODO: nihikuga**
- Üks prinditud AtomS3R makett (24 × 24 × 12,9 mm) istus stabiilselt. [Mõõdud ja foto](../tilgaplaat/measurements.md#valge-atoms3r-ekraanipoole-makett--üks-mõõdetud-eksemplar).
- Foto, kontuurikontroll, laigu pindala ja x/y nihe mudelil: **TODO**
- Seotud drops.csv / placement.csv read ja toorrõhukõver: **TODO**

## Ostsilloskoobi mõõteplaan

- Kaks kanalit: Atomi GPIO ja klapi mähise pinge; viis impulsi pikkust × kümme kordust: **TODO**
- Relee sisse-/väljalülitusviivitus, põrge, võrdlus andmelehega: **TODO**
- Elektriline kontaktieluiga lülitustes ja päevades tegeliku päevase tilgaarvu järgi: **TODO**
- Klapi mehaaniline avanemisviivitus rõhukõveralt: **TODO**
- Mähise väljalülitustipp dioodiga; dioodita katse ainult õppejõuga kooskõlastatud ohutu protseduuril: **TODO: tegemata**
- Rõhu läve ületus ja mähise vabastus, IRQ/polling ning koormatud põhitsükkel: **TODO**
