Dennel04/data-acquisition-course/data-acquisition/lab3/docs/pump_control.md

# Labor 3 pumbajuhtimise võrdlus ja uuendus

See fail ei kopeeri Laborite 1 või 2 ajaloolisi väärtusi Labori 3 tulemusteks. Varasemad allikad on:

- Labor 1: [`../../lab1/docs/pump_control.md`](../../lab1/docs/pump_control.md)
- Labor 2: [`../../lab2/docs/pump_control.md`](../../lab2/docs/pump_control.md)

Kõik siinsed Labor 3 väärtused lisatakse ainult dateeritud päris mõõtmise järel. Varasema labori väärtus tuleb enne kasutamist lähtefailist kontrollida.

## Doseerimisrõhu juhtimine

- Kontrollitud lähteallikas: **TODO**
- Doseerimisrõhu riba või muu juhtimisviis: **TODO: kPa**
- Tegelik stabiilsus ja tingimused: **TODO: päris mõõtmine**
- Mõju tilga suurusele: **TODO**
- Tegelik rõhk lahtise napaga ja väljalülitusrõhuni jõudmine: **TODO**
- Nõelventiil ainult mõõdetud vajadusel; mõju doseerimisrõhule ja imemisele: **TODO**
- Lab 2 potentsiomeetritega elektrilised katsed ei kinnita seda pneumaatikat, rõhureferentsi ega Lab 3 riba.

## Süstlaharu ohutu olek ja Y-pneumaatika

Napp on Y1 kaudu otse pumbaga ühendatud. 3/2 klapp juhib ainult süstalt: voolu all pump → süstal; vooluta süstal → atmosfäär ja pump lahutatud. Teine Y on andurile; asukoht enne klappi või süstlaharus on TODO. Tsükkel: doseerimine → klaasi tõstmine → kõvendamine → väljund.

- Vooluta rõhu vabanemine süstlaharus: **TODO: füüsiliselt mõõta**
- USB/toite kadumise käitumine: **TODO**
- Pumba ja klapi ohutu väljalülituse tõend: **TODO**

## Pooliku haarde tuletise otsus

- Labori 2 lähtefailid: **TODO: päris failiteed**
- Kasutatud filter ja selle allikas: **TODO**
- Kalde tunnus ning otsustusaeg: **TODO: ainult pärisandmetest**
- Valehäired ja piirangud: **TODO**

## Muudetud riba või seaded

- Kas Labor 3 nõudis muudatust: **TODO**
- Varasem kontrollitud seadistus: **TODO: viide, mitte oletus**
- Uus seadistus ja põhjus: **TODO: päris mõõtmine**

## Dateeritud Labor 3 tulemused

**PP.KK.AA — TODO: lisada alles pärast füüsilist sessiooni**

- Katseseadistus:
- Numbrid ja ühikud:
- Tõendifailid:
- Otsus ja põhjus:
