Dennel04/data-acquisition-course/data-acquisition/lab3/docs/recipe.md

# Labor 3 doseerimisretsept

**Kehtivus:** retsept ei kehti enne päris mõõtmisi ning vaigu/klaasi katset prinditud AtomS3 ekraanipoole mudelil. Päris Atomile vaiku ei katsetata.

- Otsik: **TODO**
- Vaik ja süstla täituvus: **TODO: tegelik märgistus ja täituvus**
- Rõhk: **TODO: kPa, mõõdetud lahtise napaga**
- Impulsi pikkus: **TODO: ms, käsk ning GPIO/mähise võrdlus**
- Kõvendamise aeg: **TODO: s, millal klaas enam ei nihku**
- LED/draiver ja must kaitsekate: **TODO: kontrollitud seadistus**
- Voolikupikkus, anduri koht ja võimalik nõelventiil: **TODO**
- Tilgaplaat ja prinditud vahetükid: **TODO: CAD/STL-viited pärast loomist**
- Kihi tegelik kõrgus ja mõõtemeetod: **TODO: mm**
- Kaamera töökõrgus, fookus ja valgustus: **TODO**
- Seansi mõõtkava ja algpilt: **TODO: mm/pixel ning fail pärast pildistamist**
- Kontrollitud kontuur, laigu pindala ning mõõtemääramatus: **TODO: px, mm², %**
- Arvutatud ruumala: **TODO: µL = mm² × mõõdetud kihi kõrgus mm**
- Mudeli mõõtude allikas, CAD ja STL: **TODO**
- Klaasikatse laigu pindala ja nihe ekraani keskpunktist: **TODO: mm², x/y mm**
- Kas laik hoiab klaasi ja jääb servast sisse: **TODO: päris katse**
- Foto/kontuuripildi tõenditee: **TODO: lisada pärast pildistamist**

## Mõõtmise alus

- Seotud [drops.csv](../data/drops.csv) ja [placement.csv](../data/placement.csv) read: **TODO**
- Seotud rõhukõverad ning foto ja kontuuri kontroll: **TODO**
- Lineaarsus, CV, esimene impulss pärast pausi ja teise muutuja võrdlus: **TODO**
- Valiku põhjendus mõõteandmetega: **TODO**

Õppejõu soovitus alustada kõige peenemast otsikust, madalast rõhust ja üle 100 ms impulssidest on lähtekoht, mitte meeskonna valitud või valideeritud retsept.
