Dennel04/data-acquisition-course/data-acquisition/lab2/docs/sources/lab2-sborka-2026-10-22.docx

Дата сборки: 22.10.2026 Плата: AtomS3R Операционный усилитель: LM358N, DIP-8 Основа схемы: макетная плата MB-102

В этой инструкции описано, как мы собрали схему, куда подключили каждый провод и резистор, зачем нужны элементы и что означают полученные измерения.

Важно: мы проверяли усилитель с двумя потенциометрами, а не с датчиком давления MPX5700AP. Поэтому результаты подтверждают работу тестовой схемы, но ещё не являются калибровкой датчика давления.

1. Что мы хотели получить

Задача лабораторной — преобразовать аналоговый сигнал датчика давления в напряжение, которое AtomS3R сможет измерять своим АЦП (ADC).

Для этого нужно:

1. Определить диапазон напряжений датчика давления.
2. Рассчитать усиление и смещение сигнала.
3. Собрать схему на LM358N.
4. Проверить её мультиметром.
5. Подключить выход усилителя к ADC AtomS3R.
6. Сравнить измерения исходного и обработанного сигналов.

В нашей текущей сборке мы выполнили проверку работы усилителя на регулируемом тестовом сигнале и подключили выход к G5 AtomS3R. Программа чтения ADC ещё не запускалась.

2. Как расположили LM358N на макетной плате

Микросхема установлена поперёк центрального разрыва макетной платы, на рядах 26–29.

Упрощённая схема расположения. Номера внутри корпуса — номера выводов LM358N, не отверстий платы.

В макетной плате отверстия A–E одного ряда электрически соединены, и отдельно соединены F–J того же ряда. Между E и F есть разрыв.

Вывод LM358N | Позиция | Назначение
1 | E26 | Выход усилителя A
2 | E27 | Инвертирующий вход A (−)
3 | E28 | Неинвертирующий вход A (+)
4 | E29 | Земля GND
5 | F29 | Неинвертирующий вход B (+)
6 | F28 | Инвертирующий вход B (−)
7 | F27 | Выход усилителя B
8 | F26 | Питание +5 V

Зачем нужны два усилителя внутри LM358N?

- Усилитель A преобразует тестовый сигнал: усиливает его и учитывает опорное напряжение.
- Усилитель B работает повторителем напряжения. Он передаёт опорное напряжение с потенциометра B100K на резистивную цепь, не нагружая потенциометр напрямую.

3. Все подключения — что куда и зачем

3.1. Питание LM358N

Откуда | Куда | Зачем
AtomS3R 5V | H26 | Питание LM358N, вывод 8
AtomS3R GND | D29 | Общая земля, вывод 4
J26 | H30 | Подача +5 V на цепь питания потенциометров

Зачем: LM358N необходимы питание и общая земля. Все измерения напряжений мы делали относительно одной земли, иначе сравнивать значения было бы неправильно.

3.2. Потенциометр B5K — тестовый входной сигнал

B5K установлен выводами в A20, A22, A24.

Откуда | Куда | Зачем
B20 | C29 | Нижний вывод B5K к GND
B22 | C28 | Средний вывод (ползунок) к входу A+
B24 | G32 | Верхний вывод B5K к питающей цепи

Поворачивая B5K, мы изменяли напряжение на входе усилителя A.

Почему использовали потенциометр: он позволил проверить схему без датчика давления. Мы могли вручную задать входное напряжение, например 0,402 V, и посмотреть, что получится на выходе.

3.3. Потенциометр B100K — опорное напряжение

B100K установлен выводами в F44, F46, F48.

Откуда | Куда | Зачем
G44 | A29 | Нижний вывод B100K к GND
G46 | H29 | Ползунок B100K к входу B+
G48 | J32 | Верхний вывод B100K к питающей цепи
H28 | H27 | Соединение выхода B с входом B−

Последний провод H28 → H27 превращает усилитель B в повторитель напряжения.

То есть, если B100K устанавливает примерно 0,520 V, то выход усилителя B должен быть примерно таким же.

Зачем нужен B100K: он задаёт опорное напряжение \(V_{ref}\), которое влияет на смещение выходного сигнала усилителя A.

3.4. Резистор 1 kΩ

Резистор установлен между I30 и I32.

Он находится в питающей цепи потенциометров и ограничивает ток через эту часть схемы.

Важно понимать: это не резистор, который определяет основной коэффициент усиления. Усиление задаётся другими резисторами.

3.5. Резистор 10 kΩ — обратная связь

Резистор установлен между A15 и A18.

Дополнительные провода:

Откуда | Куда
B15 | C26
B18 | C27

Получается:

- Один конец резистора соединён с выходом усилителя A.
- Другой конец соединён с его инвертирующим входом A−.

Это отрицательная обратная связь.

Она позволяет задать предсказуемое усиление и удерживает напряжения на входах A+ и A− близкими друг к другу при нормальной работе усилителя.

Номинал резистора — 10 kΩ. Мультиметром мы измерили 10,04 kΩ.

3.6. Три резистора по 2 kΩ — связь с опорным напряжением

Установлены последовательно:

Резистор | Позиция
№1 | I33 → I36
№2 | G36 → G39
№3 | I39 → I42

Дополнительные провода:

Откуда | Куда | Зачем
J27 | J33 | Подаём буферизованное Vref в цепь резисторов
J42 | A27 | Соединяем цепь с инвертирующим входом A−

Три резистора образуют одну последовательную цепь.

Мы измерили её суммарное сопротивление: 6,51 kΩ.

Зачем: совместно с резистором 10,04 kΩ эта цепь задаёт коэффициенты усиления входного сигнала и смещения относительно опорного напряжения.

3.7. Подключение ADC AtomS3R

После проверки напряжения выхода мы подключили:

Откуда | Куда
A26 | AtomS3R G5

A26 находится на той же электрической линии, что и выход усилителя A (E26).

Перед подключением USB-питание было отключено. Затем USB подключили обратно.

Зачем: G5 используется как вход ADC, чтобы AtomS3R мог измерять напряжение, сформированное усилителем.

Однако мы ещё не загрузили и не проверили программу ADC. Также мы не подтвердили безопасность напряжения во всём диапазоне регулировки. Поэтому наличие провода на G5 не означает, что весь диапазон схемы уже безопасен для микроконтроллера.

4. Что именно измеряли и зачем

Измерение №1 — питание LM358N

H26 относительно D29

5,00 V

Что проверяли: получает ли микросхема питание.

Что означает результат: на LM358N действительно подаётся около 5 V. Без этого нельзя было бы ожидать нормальной работы усилителя.

Что даёт для лабораторной: подтверждает фактическое питание тестовой схемы. При расчёте реального усилителя нужно учитывать, что LM358N не способен идеально выдавать любое напряжение от 0 до 5 V.

Измерение №2 — вход усилителя A

C28 относительно D29

0,402 V

Что проверяли: какое напряжение B5K подаёт на неинвертирующий вход A+.

Что означает: входной тестовый сигнал в данном положении потенциометра равен 0,402 V.

Что даёт: это известное \(V_{in}\), с которым можно рассчитать ожидаемое выходное напряжение.

Это не измерение давления и не подтверждённое минимальное напряжение датчика.

Измерение №3 — инвертирующий вход усилителя A

C27 относительно D29

0,403 V

Что проверяли: действует ли отрицательная обратная связь.

Сравним:

A+ (C28)

0,402 V

A− (C27)

0,403 V

Разница:

\[ 0{,}403-0{,}402=0{,}001\ \text{V} \]

То есть 1 mV.

Что означает: оба входа почти на одном уровне, как и ожидается при отрицательной обратной связи в линейном режиме.

Что даёт: это важный признак, что в проверенном рабочем состоянии обратная связь действительно работает. Но одного измерения недостаточно, чтобы подтвердить линейность всей схемы.

Измерение №4 — опорное напряжение

J27 относительно D29

0,520 V

Что проверяли: какое напряжение выдаёт усилитель B, работающий как повторитель.

Что означает: в резистивную цепь первого усилителя подаётся опорное напряжение 0,520 V.

Зачем оно нужно: опорное напряжение позволяет смещать выходную характеристику. Это необходимо, когда сигнал датчика нужно преобразовать в заданный диапазон для ADC.

Например, нам может понадобиться, чтобы минимальный сигнал датчика соответствовал не нулю вольт, а некоторому положительному напряжению. Для этого подбираются схема, усиление и смещение.

Измерение №5 — выход усилителя A

C26 относительно D29

0,205 V

Что проверяли: какое выходное напряжение получается при входе 0,402 V и опорном напряжении 0,520 V.

Что означает: схема выдала 0,205 V.

Само по себе значение 0,205 V не говорит, исправна ли схема. Чтобы это понять, нужно сравнить измерение с расчётом.

5. Расчёт усиления и сравнение с измерениями

В нашей схеме:

- \(R_f=10{,}04\ \text{k}\Omega\) — резистор обратной связи.
- \(R_{ref}=6{,}51\ \text{k}\Omega\) — резистивная цепь от опорного напряжения.
- \(V_{in}=0{,}402\ \text{V}\).
- \(V_{ref}=0{,}520\ \text{V}\).

Для идеального усилителя:

\[ V_{out}=\left(1+\frac{R_f}{R_{ref}}\right)V_{in}-\frac{R_f}{R_{ref}}V_{ref} \]

Сначала рассчитываем отношение сопротивлений:

\[ \frac{10{,}04}{6{,}51}\approx1{,}542 \]

Получаем:

\[ V_{out}\approx2{,}542V_{in}-1{,}542V_{ref} \]

Подставляем измеренные значения:

\[ V_{out}\approx2{,}542\cdot0{,}402-1{,}542\cdot0{,}520 \]

\[ \boxed{V_{out,\ расч}\approx0{,}220\ \text{V}} \]

А мультиметр показал:

\[ \boxed{V_{out,\ измер}=0{,}205\ \text{V}} \]

Сравнение расчёта и измерения

Расчётное

0,220 V

Измеренное

0,205 V

Разница

0,015 V (15 mV)

Что это даёт лабораторной: у нас есть проверка схемы в одном рабочем состоянии. Измеренный выход близок к теоретическому.

Разницу могут объяснять неидеальность LM358N, допуски компонентов, погрешность измерений и контактные сопротивления. Но точную причину расхождения мы не установили, поэтому нельзя утверждать, что оно вызвано каким-то одним фактором.

6. Зачем мы получили 3,009 V

После первой проверки мы повернули B5K, изменив входное напряжение.

На выходе C26 измерили:

Выход усилителя после регулировки B5K

3,009 V

Одна измеренная рабочая точка

Что мы хотели проверить: способен ли усилитель выдавать напряжение заметно выше первоначальных 0,205 V.

Что показывает результат: регулировка входного сигнала действительно изменила выход, и мы смогли получить около 3 V.

Чего результат не доказывает: что выход всегда остаётся ниже 3,3 V, что схема линейна во всём диапазоне или что 3,009 V соответствует максимальному давлению.

Мы не записали входное напряжение именно для этой точки, поэтому использовать её для точной проверки коэффициента усиления нельзя.

7. Как эти измерения помогают выполнить лабораторную работу

Требование лабораторной | Что уже получили | Что ещё необходимо
Собрать аналоговый усилитель | LM358N подключён и проверен | Проверить работу с датчиком
Проверить питание | 5,00 V | Проверить питание датчика
Рассчитать преобразование сигнала | Получена формула с реальными сопротивлениями | Пересчитать по диапазону MPX5700AP
Проверить усилитель | 0,205 V измерено против 0,220 V расчётного | Проверить несколько точек
Проверить диапазон выхода | Получено 3,009 V | Проверить оба края и промежуточные точки
Подключить AtomS3R | Провод выхода подключён к G5 | Проверить безопасный диапазон и запустить ADC
Сравнить raw и opamp | Пока нет данных | Записать оба сигнала
Оценить шум и точность | Пока нет данных | Провести измерения и расчёт SNR
Проверить управление насосом | Не выполнено | Сравнить управление с raw и opamp

8. Что делать дальше по заданию

Следующий основной этап — измерить реальный сигнал MPX5700AP, поскольку именно он должен определять окончательную схему преобразования.

Нужно получить напряжения датчика при атмосферном давлении, полном всасывании и полном нагнетании. После этого можно определить реальный диапазон входного сигнала, рассчитать подходящее усиление и смещение, а затем проверить, укладывается ли выход в допустимый диапазон ADC.

Далее потребуются измерения осциллоскопом, сравнение исходного и усиленного сигналов, сохранение данных в CSV, расчёт разрешения в Па на код ADC и оценка шума.

9. Итог нашей сборки

В результате работы 22.10.2026 мы:

- Собрали тестовую схему на LM358N с двумя потенциометрами.
- Использовали один канал для усиления и смещения, другой — для буферизации опорного напряжения.
- Измерили фактические сопротивления 10,04 kΩ и 6,51 kΩ.
- Подтвердили питание около 5 V.
- Проверили, что напряжения на входах A+ и A− практически совпадают.
- Получили на выходе 0,205 V при расчётном значении около 0,220 V.
- Получили 3,009 V после регулировки входного сигнала.
- Подключили выход к G5 AtomS3R при отключённом USB-питании.

Главный результат для лабораторной: мы получили экспериментальное подтверждение работы аналоговой схемы в одной рассчитанной точке и показали возможность регулировать её выходное напряжение. Это основа для следующего этапа — подключения настоящего датчика давления, калибровки и цифрового сбора данных через AtomS3R.

При этом лабораторная ещё не завершена: реальный датчик, ADC-измерения, осциллограммы, CSV и сравнение шума остаются отдельными задачами.

ja otklu4il atom provoda, nado podlju4i nazad ego 3 provoda 5v, g i g5?

Да, правильно. В нашей схеме к AtomS3R подключаются 3 провода:

AtomS3R | Куда на макетной плате | Назначение
5V | H26 | Питание LM358N
G (GND) | D29 | Общая земля
G5 | A26 | Вход ADC от выхода LM358N

Подключай только при отключённом USB-питании AtomS3R.

Сначала подключи провод 5V → H26.

Напиши «готово», и перейдём к GND, затем к G5.

Перед включением USB проверим все три соединения. Особенно важно убедиться, что напряжение на G5 не превышает допустимое для ADC.
