Dennel04/data-acquisition-course/study-ru/README.md

# Русские переводы

Эти файлы содержат неофициальные русские переводы учебных заданий. При
расхождении приоритет имеет оригинал преподавателя на эстонском языке.

- [Lab 1](lab1-translation.md)
- [Lab 2](lab2-translation.md)
- [Lab 3](lab3-translation.md)

`session-02.10.26.md` и `source-lab2-est.md` являются отдельными
вспомогательными материалами, а не переводами других лабораторных заданий.
