Dennel04/data-acquisition-course/data-acquisition/lab3/tilgaplaat/photos/README.md

# Fototõendid — 14.11.2026

- [`2026-11-14-atoms3r-makets.jpg`](2026-11-14-atoms3r-makets.jpg) — prinditud valged AtomS3R maketid.
- [`2026-11-14-white-v2-top.jpg`](2026-11-14-white-v2-top.jpg) — valge V2 pealtvaade.
- [`2026-11-14-white-v2-ruler.jpg`](2026-11-14-white-v2-ruler.jpg) — valge V2 koos joonlauaga tööalal.
- [V1 pildid](../v1/README.md) — oranž plaat ning V1/V2 võrdlus.

Kasutaja edastas originaal-JPEG-id 14.11.2026 arhiivis `lab3_evidence_2026-11-14.zip`. Kõik viis fotot säilitavad arhiivis olnud failisisu. Füüsilised mõõdud on [mõõtelehel](../measurements.md).
