Dennel04/data-acquisition-course/data-acquisition/lab3/docs/falstad/README.md

# Labor 3 Falstadi tõendid

- LM358N teise poole komparaatoriskeem: **TODO: pärast Lab 2 viitepuhvri vajaduse kontrolli**
- Hüstereesiga Schmitti trigeri skeem: **TODO**
- Elav Falstadi URL: **TODO**
- Falstadi ekspordifail: **TODO**
- Skeemi ekraanipilt: **TODO**
- Tavalise tilga katsesisend ja tulemus: **TODO: pärisandmetest**
- Kinnise otsiku katsesisend ja tulemus: **TODO: pärisandmetest**
- Müraga tavalise tilga katsesisend ja tulemus: **TODO: pärisandmetest**
- Lävi, hüstereesi laius ja takistite väärtused: **TODO: valida pärast pärisandmeid**

Simulatsioon ei tõenda, et füüsiline ahel töötab.

Sisend tuleb päris normal / clogged / empty andmetest valitud rõhu- või dP/dt tunnusest. Enne tuletist võrrelda libisevat keskmist ja mediaani. Hüstereesi takistid ning läved jäävad TODO. Füüsilise LM358N väljundi madal/kõrge pinge ja üleminekud mõõdetakse enne Atomi ühendamist; vajadusel sobitus, mitte eeldus 3,3 V ohutusest.
