Dennel04/data-acquisition-course/study-ru/lab3-translation.md

> **Вспомогательный перевод.** Это неофициальный русский перевод задания преподавателя. При расхождении приоритет имеет [эстонский оригинал](https://github.com/KKallas/Narva-subjects/blob/a0b83a009a1c77102d0337fb452e32aef3eee655/EST/2026-27/Data%20Acquisition/Data%20Acquisition%20%5BLab%203%5D%20EST.md).

## Сбор данных: Лабораторная работа 3 — Капля и прерывание

**Объём работы:** 30 часов | **Оценка:** 20 баллов | **Команда:** 3 студента | **Выдано:** 28.10.26 | **Дата заказа:** 06.11.26 | **Первая защита:** 19.11.26, онлайн

### Как работает этот документ

* Репозиторий и порядок работы остаются такими же, как в Лабораторной работе 1.
* Перенесите все, что вам нужно из этого документа, в репозиторий вашего проекта: папку для этой лабораторной работы `README.md`, где хранятся ваши собственные цифры, решения и ответы ЗАПОЛНИТЕ САМИ (KAARDISTA ISE), а также файлы, названные в контрольном списке. Копировать весь документ не обязательно.
* Диаграммы и симуляции передаются в документ в виде изображения со ссылкой на живой файл рядом с изображением, чтобы другой человек мог открыть его и изменить в дальнейшем.

### Цель

До сих пор насос выполнял одну работу: всасывал, а присоска удерживал стекло. Теперь тот же насос выполняет еще одну работу. Он дует в шприц, и из кончика шприца выходит капля клея. Электромагнитный клапан решает, какую работу выполняет насос в данный момент, и клапан управляется вашим Atom.

Клей представляет собой прозрачную смолу, которая отверждается под действием света с длиной волны 405 нм. Капля попадает на экран Atom, стекло на каплю, а УФ LED отверждает клей через стекло.

Это приводит к двум вопросам, и это две стороны этой лаборатории.

**Насколько велика капля?** Размер капли равен давлению, умноженному на время, умноженное на открытие сопла, плюс количество смолы в шприце, насколько тепло в помещении и длина шланга. Слишком маленькая капля не удержит стекло. Слишком большой выдавливается из-под стекла и на бока Атома. Насколько велико добро, теперь никто не знает; это число, которое вы измеряете. В результате получается **рецепт**: сопло, давление, длина импульса, время отверждения.

**Что, если что-то пойдет не так?** Две вещи обязательно пойдут не так.

* **Насадка затвердевает.** При дневном свете достаточно УФ-излучения, а лампа находится рядом с ней. Шприц с закрытой насадкой представляет собой закрытую емкость, в которую нагнетает насос. Клей не придет, давление будет.
* **Шприц заканчивается.** Из сопла выходит воздух, а не клей, и робот ставит стакан поверх сухого Атома.

В любом случае клапан должен немедленно вернуться назад, и робот должен знать об этом. «Немедленно» не означает, когда станция спросит в следующий раз. Станция находится по другую сторону кабеля USB от ноутбука, и в данный момент у него есть другие дела. Решение о том, где находится датчик, принимается не в основном цикле программы, а посредством **прерывания**: аппаратное обеспечение само сообщает процессору сейчас, а процессор оставляет все остальное.

в Лабораторной работе 2 допускает, что **наклон** давления является работой Лабораторной работы 3. Вот. Что отличало полухват от приличного, так это то, как быстро падало давление. Что отличает закрытое сопло от открытого, так это то, как повышается давление. Оба являются производными, и у производной есть одно неприятное свойство, которое вы можете увидеть сами с помощью Фурье: она усиливает шум, причем тем сильнее, чем выше частота. Следовательно, фильтр идет перед производной, а не после нее.

В этой лаборатории есть четыре вещи:

1. **Вентилятор и импульс.** Atom переключает клапан, длина импульса считывается аппаратным таймером, а осциллограф сообщает, какой на самом деле длился импульс.
2. **Размер капли.** Импульсы разной длины, капли разного размера, кривая давления каждой капли. Вот тут-то и пригодится рецепт.
3. **Фильтр и производная**. На сохраненных кривых: необработанный наклон, отфильтрованный наклон и спектр, показывающий, почему одна из них бесполезна.
4. **Прерывание.** Компаратор в Фалстаде, затем на борту. Засоренное сопло и пустой шприц действительно проверяли, и время отклика осциллографа.

В первый день новых запчастей нет. Постройте из того, что есть на полке, и напишите заказ недостающих компонентов к 06.11.

*Это живой документ. Обновляйте цели, если они меняются в процессе работы — новые знания иногда делают старые цели бессмысленными. Идея состоит в том, чтобы постоянно держать команду на цели, чтобы не затеряться в дебри деталей и не оставить нерешенной главную проблему.*

**ЗАПОЛНИТЕ САМИ (KAARDISTA ISE) — Цель, как она есть на самом деле.**

### Контрольный список

**Необходимо сделать**

- [ ] Клапан включает Атом по команде. Насос стоит на ступице без питания. Измерено, а не предполагается.
- [ ] Длина импульса считывается аппаратным таймером. Команда и осциллограф измеряли длину рядом для пяти длин.
- [ ] UV LED включает Atom по команде и всегда очищается.
- [ ] Расположение датчика в шланге выбрано и обосновано.
- [ ] Капли: не менее пяти импульсов длительности, по десять капель каждая, каждая капля измеряется и кривая давления каждой капли записывается. Файл `data/drops.csv`.
- [ ] Попробована вторая переменная: вторая форсунка или второе давление, с тремя длинами импульса.
- [ ] Рецепт записан в файле `docs/recipe.md`: сопло, давление, импульс, время отверждения, и по этой капле проверялось стекло.
- [ ] Необработанный и отфильтрованный наклон рядом на одной кривой, спектры рядом. Фильтровать по выбранным номерам.
- [ ] Тот же наклон в журнале частичного захвата Лабораторной работы 2: теперь принимается решение о том, «удерживается ли вакуум».
- [ ] Компаратор в Фалстаде: включает закрытое сопло, не включает нормальное падение или шум.
- [ ] Компаратор на плате, прерывание в Atom: клапан возвращается, сигнализация заблокирована, событие выключено.
- [ ] Время отклика осциллографа, десять раз, с перерывом и без. Файл `docs/latency.csv`.
- [ ] Закройте сопло десять раз и опустошите шприц десять раз: ударьте много раз. Обычное падение в тридцать раз: несколько ложных срабатываний.
- [ ] Заказ от 06.11 в файле `docs/bom.md`.
- [ ] Журнал репозитория и разработки завершен, тег `data-acquisition-lab3`.

**ЗАПОЛНИТЕ САМИ (KAARDISTA ISE) — даты и ваши собственные шаги.**

### Входы

* из Лабораторной работы 1 и 2: Датчик с шагом, регистратор 100 Гц, формат CSV, управление насосом с помощью ленты (`pump_control.md`), журналы с половинным захватом.
* От преподавателя: электромагнитный клапан 3/2, модуль MOSFET для срабатывания клапана, смола, шприцы и наконечники трех размеров, колпачки для наконечников, 405 нм с драйвером LED, очки 405 нм, нитриловые перчатки, изопропанол. Одна насадка специально закалена.
* С полки: Компаратор или другая сторона LM358N, набор резисторов и конденсаторов, осциллограф, мультиметр, штангенциркуль.
* Из L3 3D-печати: инструмент, удерживающий шприц, и воздушное соединение шприца, удерживающее давление. Пока он есть, шприц стоит в подставке на столе.
* Из Smart Solutions L3: страница Atom, на которой расположены кнопки настроек клапана, LED и тестирования.

### Инструменты

1. Кабели AtomS3, USB-C
2. Ваш датчик и градус из Лабораторной работы 2
3. 3/2 электромагнитный клапан, модуль MOSFET, защитный диод
4. Шприцы, насадки, колпачки для насадок, смола 405 нм.
5. 405 нм с драйвером LED; защитные очки, нитриловые перчатки, изопропанол, бумажные полотенца.
6. Компаратор (LM393) или LM358N, набор резисторов и конденсаторов, макетная плата.
7. Осциллограф двухканальный; мультиметр
8. Суппорт; вес 0,01 г, если есть
9. MG400 с насосной коробкой
10. Arduino IDE или PlatformIO; Python 3, Jupyter Lab, numpy, pandas, scipy, matplotlib
11. Falstad; git

*Если план изменится, обновите также инструменты или создайте диаграмму draw.io, показывающую, как все работает вместе.*

**ЗАПОЛНИТЕ САМИ (KAARDISTA ISE) — который вы действительно использовали.**

### Справочная информация

* **ESP32 Прерывание**
[https://www.youtube.com/watch?v=WVK2Wx386XE](https://www.youtube.com/watch?v=WVK2Wx386XE)
* **Триггер Шмитта** — компаратор, не вибрирующий на пороге
[https://www.youtube.com/watch?v=Nrp8OgQLAlw](https://www.youtube.com/watch?v=Nrp8OgQLAlw)
* **Фильтр нижних частот**
[https://www.youtube.com/watch?v=OBM5T5_kgdI](https://www.youtube.com/watch?v=OBM5T5_kgdI)
* **Фильтр верхних частот** — то же, что и производная, только с другим именем.
[https://www.youtube.com/watch?v=H30kRgI5bi0](https://www.youtube.com/watch?v=H30kRgI5bi0)
* **Управление шумом**
[https://www.youtube.com/watch?v=u40kX1DYKdA](https://www.youtube.com/watch?v=u40kX1DYKdA)
* **Как работает ОУ** — компаратор — тот же треугольник без обратной связи
[https://www.youtube.com/watch?v=kbVqTMy8HMg](https://www.youtube.com/watch?v=kbVqTMy8HMg)
* **Соленоид, MOSFET и защитный диод**
(ссылка отсутствует — YouTube: «объяснение обратноходового диодного соленоида MOSFET»)
* **ESP32 аппаратный таймер**
(ссылка отсутствует — YouTube: «ESP32 прерывание аппаратного таймера»)
* **Falstad**
[https://www.falstad.com/circuit/circuitjs.html](https://www.falstad.com/circuit/circuitjs.html)

*Добавьте сюда свои источники и полезную информацию, которая поможет вам разобраться в проекте даже спустя годы, когда вы откроете его снова.*

**ЗАПОЛНИТЕ САМИ (KAARDISTA ISE) — ваши источники.**

### Детали

#### 1. Клапан и пульс

Клапан представляет собой катушку, и катушке требуется больший ток, чем может обеспечить вывод Atom, и другое напряжение. Модуль MOSFET иногда работает. Прежде чем что-либо подключать, прочтите, какое напряжение требуется на клапане.

У катушки есть одно свойство, ломающее электронику: при отключении тока катушка на мгновение вырабатывает напряжение, во много раз превышающее питающее. **Защитный диод** наверху катушки улавливает его. Посмотрите, есть ли он в вашем модуле. Если нет, поставьте. Осциллограф покажет вам этот пик без диода и с диодом — сделайте этот снимок до того, как Atom окажется в той же цепи.

**Безопасное состояние.** Клапан подпружинен: при отсутствии тока он возвращается в одно фиксированное положение. Это позиция должна быть присоска, а не шприца. Проверьте это по-настоящему: вытащите USB из Atom, заправьте насос и посмотрите, есть ли давление в рычаге шприца. Не должно быть. Это то же правило, что и в Лабораторной работе 1: если что-то не так, ничего не происходит.

**Импульс.** Падение — это время открытия клапана. Если это время отсчитывает основной цикл программы, который одновременно рисует экран и отправляет строки, то импульс каждый раз немного отличается по длине, как и падение. Длительность импульса отсчитывает **аппаратный таймер**: указываешь ему миллисекунды, он сам закрывает клапан, независимо от того, что в этот момент делает остальная часть программы. Измерьте осциллографом управляющий сигнал клапана: команда была 200 мс, какой длительности был импульс? Пять длин по десять раз каждая. Среднее и дисперсия.

И еще одна вещь, которую не видит осциллограф: сам клапан механический, и для его открытия требуется время. Кривая давления показывает это. Через какое время после команды давление в шприцевом кронштейне начинает повышаться? Это самый короткий импульс, который вообще имеет какой-либо смысл.

**Там, где находится датчик.** У вас один датчик. Он может сидеть между насосом и клапаном: тогда ему видны обе ветки, но либо через клапан. Или на отводке шприца: тогда каплю он видит резко, а присоска совсем нет. Выберите и скажите, от чего вы отказались.

**UV LED** обрабатывается так же: Atom включает его через драйвер, а таймер выключает. LED не горит, поскольку не поступила команда «выключить».

```
arvuti → Atom:  {"cmd":"dispense","ms":200}    {"cmd":"uv","ms":5000}    {"cmd":"clear"}
Atom → arvuti:  {"ev":"dispense_start","t":123456}    {"ev":"dispense_end","t":123660}
```

Запишите: напряжение клапана и способ его подключения, схему в виде рисунка; изображение осциллографа при обесточенной катушке; каково давление в шприцевом кронштейне, когда Atom выключен; таблица длительности импульсов, командная и измеряемая; задержка открытия клапана по кривой давления; расположение датчика и причина.

#### 2. Размер капли

Во-первых, то, что вы держите на месте. Давление: Бар Лабораторной работы 1 удерживает насос между двумя точками переключения, а также он работает при продувке. Сделайте полоску узкой и запишите давление, при котором вы дозируете. Совет: начните со среднего. Шприц: полный и отметьте, когда он заполнен.

Затем измените одну вещь: длину импульса. Минимум пять длин, от самой короткой, которая вообще ничего не выдает, до явно слишком большой. По десять капель с каждого. Капли попадают на основу образца — бумагу, пленку или жертвенное стекло, закаливаются лампой и измеряются. Диаметр с штангенциркулем. Если у вас гиря 0,01 г, то и масса, потому что диаметр зависит от того, как растечется капля, а масса – нет.

Кривая давления также записывается для каждой капли с тем же номером капли. Это не бумажная работа. Вы хотите знать, предсказывает ли кривая размер капли — соответствует ли высота плато или площадь под кривой размеру капли. При беге каждую каплю можно проверить, не измеряя ее. Лаборатория 5 основана на этом.

Три вещи, на которые стоит обратить внимание:

* **Зависимость прямая?** В два раза больше импульс, в два раза больше падение? Если нет, то где он гнется и почему?
* **Сколько раскачивается один и тот же импульс?** Десять падений с одной и той же командой — это не десять одинаковых падений. Стандартное отклонение, деленное на среднее значение. Это число показывает, насколько точна ваша дозировка, и оно буква соответствует среднему значению.
* **Первая капля.** Является ли первая капля после перерыва такой же, как десятая? Если нет, то поэтому на столе стоит мусорное ведро.

Затем поменяйте что-нибудь и повторите короче: другое сопло или другое давление, три длины импульса. Что больше влияет на падение, время или диафрагма?

И наконец настоящий эксперимент. Упадите на манекен Атома, на стекло, посмотрите через стекло. Клей должен покрывать достаточно, чтобы держаться, но не доходить до края. Решите, какая капля лучше. Затвердейте и измерьте, сколько времени это займет: когда стекло перестанет двигаться.

Запишите: строки в файле `data/drops.csv` (номер капли, сопло, давление, импульс мс, диаметр мм, масса мг, если есть, файл кривой, примечание); график зависимости размера капли от длины импульса с разбросом; процентное изменение для каждой длины; соответствует ли плато или площадь поверхности кривой размеру капли; Рецепт в файле `docs/recipe.md` — наконечник, давление, пульс, время отверждения и фотография стекла над этой каплей.

#### 3. Фильтр и производная

Эта часть делается на компьютере, по уже имеющимся у вас лекалам.

Возьмите одну кривую падения и рассчитайте наклон самым простым способом: `dP/dt = (P praegu − P eelmine) / 10 ms`. Рисовать. Это не похоже на уклон, это похоже на шум, и причина вполне объяснима. Производная умножает каждую частоту на ее собственную частоту: медленное изменение, которое вы ищете, остается небольшим, а быстрое дрожание, которое вы не ищете, становится большим. Составьте спектр сигнала и спектр производной и поместите их рядом. Коэффициент на каждой частоте равен `2πf`. По спектру Лабораторной работы 1 вы уже знаете, какие там пики; теперь вы можете видеть, какой из них портит вывод.

Поэтому сначала отфильтруйте. Попробуйте хотя бы два: скользящую среднюю и медиану. Они не делают то же самое: среднее значение расширяет одну острую точку, а медиана ее отбрасывает. Два числа для каждого фильтра: сколько шума осталось в производной и **насколько запаздывает фильтр**. Фильтр не бесплатный. Среднее десятибалльное значение узнает об изменении только тогда, когда ему уже исполнилось половину своего окна. Для прерывания эта задержка является частью времени отклика.

Выберите один. Причина в том, что два числа расположены рядом друг с другом, а не в том, что «стало более плавно».

Затем сделайте то же самое, что обещал Лабораторная работа 2. Возьмите логи частичного захвата и посчитайте по ним отфильтрованный уклон после выключения насоса. в Лабораторной работе 2 спросил, сколько секунд нужно, чтобы отличить неполный хват от хорошего. Теперь вопрос: есть ли порог наклона, который их разделяет, и как быстро? Это решение «остаться в вакууме», и робот его подхватывает.

И наконец, для чего нужна Часть 4. Поместите три кривые рядом: нормальная капля, закрытый наконечник, пустой шприц. Что их отличает — наклон подъема, высота плато или то, как падает давление после закрытия клапана? Никто не знает этого заранее. Посмотрите свои данные и выберите характеристику, по которой переключается прерывание.

Запишите: необработанный и отфильтрованный наклон на одной кривой; спектры рядом; шум и задержка каждого фильтра и какой из них вы выбрали; порог наклона между хорошим и частичным пониманием и время принятия решения; три кривые дозировки рядом и отличительный признак с цифрами.

#### 4. Прерывание

Сейчас такое же решение принято аппаратно.

**Сначала Фальстад.** Компаратор сравнивает два напряжения, и его выходной сигнал является одним из двух: высоким или низким. На один вход поступает ваш сигнал — либо выход самого каскада, либо его производная, в зависимости от того, что вы выбрали в части 3, — а на другом — порог. Три входа, которые стоит попробовать: обычная капля, закрытое сопло и нормальная капля с шумом сверху. Компаратор должен переключиться на второй, а не на первый или третий.

Третье — то, что не получается с первого раза. Когда сигнал достигает порога, шум переключает компаратор туда и обратно десятки раз. Решением является **гистерезис**: немного от выхода обратно ко входу, поэтому порог включения выше, чем порог выключения. Это триггер Шмитта, и его идея та же, что и у панели управления насосом Лабораторной работы 1: два порога вместо одного, чтобы предотвратить дрожание устройства. Резисторы производства Falstad.

**Затем на плате.** Выход компаратора поступает на вывод Atom, который вызывает прерывание. Измерьте мультиметром, чтобы выходное напряжение не превышало 3,3 В до того, как оно поступит на Atom.

```
dispense: kui alarm on lukus → keeldu
          klapp süstlale → taimer loeb ms → klapp tagasi napale
katkestus: klapp kohe napale → alarm lukku → {"ev":"alarm","why":"clog"} välja
tühi süstal: kui rõhk ei jõua platoole ettenähtud aja sees → alarm lukku, "empty"
alarm püsib, kuni tuleb {"cmd":"clear"}
```

Во время перерыва делается как можно меньше: створка закрыта, флажок поднят. Все остальное — экран, линия к компьютеру — делается позже, в основном цикле. Сигнализация остается заблокированной. Система, которая повторяет попытку после блокировки, второй раз закачивает жидкость в заблокированный шприц.

**Измерьте скорость.** Один канал осциллографа — это давление, другой — сигнал управления клапаном. Закрытое сопло сверху. Время от момента превышения давления порога до момента отпускания клапана. Десять раз.

Дальше строим такую же защиту без перерыва: основной цикл с каждым раундом считывает датчик и сравнивает с порогом. Измерьте одно и то же время десять раз. А потом запустить основной цикл — нарисовать на экране, отправить линии — и снова измерить. Номер прерывания не должен меняться. Меняется основной цикл. Также запишите, сколько времени потребовалось, чтобы оба варианта заработали: обычно более быстрое решение — это то, над которым потребовалось больше времени, и оба числа являются частью решения.

**И, наконец, настоящее испытание.** Засорение форсунки десять раз: сколько раз сработала сигнализация. Пустой шприц, десять раз. Нормальное падение по рецепту, тридцать раз: сколько раз сработала сигнализация, когда ее не должно было быть. Защита, дающая ложные срабатывания, отключается на третий день, и дальше защиты нет.

Запишите: диаграмму Фалстада в виде изображения и связи, резисторы, порог и ширину гистерезиса; осциллографическое изображение порога и клапана на одном экране; строки в `docs/latency.csv` (пробный, путь, нагрузка, время мс), средние и худшие с перерывом и без; ложные срабатывания от десяти закрытых насадок, ложные срабатывания от десяти пустых шприцев, тридцати нормальных капель; время разработки любого решения; одно предложение, какое из них вы оставляете и почему.

**ЗАПОЛНИТЕ САМИ (KAARDISTA ISE) — ответы.** Для каждой части: цифры, единицы измерения, где находится файл. Одна строчка о незавершенном деле, почему.

### Безопасность

* **Свет и глаза 405 нм.** LED не просматривается. Когда на драйвере стоит LED, все за столом надевают 405-нм очки. Лампа направлена в сторону стола. LED всегда выключается сам по таймеру, а без питания отключается.
* **Смола.** Незатвердевшая смола раздражает кожу и может вызвать непроходящую аллергию. Нитриловые перчатки при открытом шприце. Смолу стирают изопропанолом и бумагой, а перед утилизацией бумагу отверждают под лампой. Не выливайте незастывшую смолу в раковину.
* **Лампа не направлена на сопло.** Закаленное сопло — это ошибка, которую вы научитесь обнаруживать здесь. Один из них сделан специально и дается преподавателем.
* **Закрытый шприц представляет собой закрытый контейнер под давлением.** Во время окклюзионной пробы шприц находится в держателе или подставке, а не в руке. Прежде чем вынимать шприц, сбросьте давление через клапан. До тех пор, пока не будет предпринята попытка разрыва, при каждой попытке блокировки человеческая рука находится на выключателе насоса.
* **На насадке имеется колпачок**, если вы не дозируете. Дневной свет медленно, но верно затвердевает клей в насадке.
* **Катушка и диод.** Клапан не будет переключаться без защитного диода. Напряжение клапана не соответствует напряжению атома: две половины модуля MOSFET не совпадают.
* **Вывод ADC и вывод прерывания не выдерживают напряжения 5 В.** Выходной сигнал компаратора измеряется мультиметром перед тем, как он поступит на Atom.
* USB и отключите питание, прежде чем перемещать провод. Насосная коробка рассчитана на 24 В.
* Ослабленный шланг при +110 кПа слетает; ни на кого не ссылайтесь.
* Робот: руки не лежат на столе, когда робот включен. Первоначально вы измеряете падение на столе, а не на конце робота.
* В этой лаборатории пайка запрещена.

### Компоненты для этой лабораторной работы

Заказ выходит 06.11.26 и прибудет до защиты. Готового списка нет: команда собирает сам заказ в файле `docs/bom.md`, по одному предложению на каждую строку, какая часть или номер его просит.

Заказ осуществляется из общей таблицы заказа: [https://moodle.ut.ee/mod/url/view.php?id=1535601](https://moodle.ut.ee/mod/url/view.php?id=1535601). Получите свои строки до даты заказа; того, чего нет в таблице, не заказывают. Файл `docs/bom.md` остается в вашем репозитории как причина, по которой вы запросили эти вещи.

Подумайте, например: есть ли на вашем модуле MOSFET защитный диод или он поставляется отдельно; имеет ли отдельный чип больше смысла в качестве компаратора, чем другая сторона LM358N, и что говорится в паспорте о его выходе; присутствуют ли в комплекте резисторы гистерезиса, обозначенные Falstad; достаточно ли патрубков и колпачков, если каждая засоренная форсунка – это потерянная форсунка; смола для пятидесяти капель и некоторых неудач; а чем измерить падение, если штангенциркуля не хватает.

### Критерии оценки

| Категория | Очки |
| :--- | :--- |
| Рабочие файлы — Прошивка Atom с таймером, блокировкой прерываний и тревог, логгером, `drops.csv` с кривыми, блокнотом для анализа | 5 р |
| Анализ — импульс, команда и измеренное значение, размер капли в сравнении с импульсом с дисперсией, необработанные и отфильтрованные наклонные спектры, задержка фильтра, время отклика с разрывом и без него | 5 р |
| Прототип - клапан на наппе без тока, капля по рецепту держит стекло и не доходит до края, закрытая насадка и пустой шприц подают сигнал тревоги, нормальная капля - нет | 5 р |
| Документация — README, журнал разработки, `recipe.md`, `latency.csv`, экспорт Falstad, `pump_control.md` обновлено, `bom.md`, AGENTS.md | 5 р |
| **Всего** | **20 дней** |

### Защита

Ссылка на репозиторий git, тег `data-acquisition-lab3`.

Защита представляет собой простое устное обсуждение продолжительностью 15 минут. Вы делаете одну каплю по рецепту и показываете ее кривую давления. Вы надеваете закрытое сопло и показываете на осциллографе, как и с какой скоростью открывается клапан. Вы показываете, что второй капли не будет, пока не будет снята тревога. Вы открываете свой журнал развития. Лектор задаст около пяти вопросов о том, как вы это сделали. Если у вас не получится с первого раза, вы придете снова.

В репозитории есть папка `data-acquisition/lab3/`: `src/` с прошивкой и регистратором, папка `data/` с `drops.csv` и кривыми, `notebooks/` с каплями, наклоном и спектрами, схематическая фотография `docs/`, изображения осциллографа, экспорт Falstad, `recipe.md`, `latency.csv`, обновленные `pump_control.md` и С `bom.md`, `README.md` для этой лабораторной работы и `AGENTS.md` обновленными.

### Дневник разработки

**ЗАПОЛНИТЕ САМИ (KAARDISTA ISE) — Дневник.** Одна запись по каждому рабочему сеансу, написанная для себя, чтобы мог понять тот, кто там не был. Записи добавляются, а не изменяются.

Прилагательные не являются результатами. «Капли были неровными» — это пустяки; «Импульс 200 мс, десять капель, 3,1 ± 0,4 мм» — это запись.

**ДД.ММ.ГГ — кто присутствовал**
* Мы сделали:
* Инцидент (цифры):
* Мы решили, и почему:
* Открыто в следующий раз:

### Итоги и результаты

**Результаты**
* Smart Solutions L3: команды Valve и LED с настройками и кнопками тестирования переходят на страницу Atom; тревожное событие, при котором станция останавливает робота.
* 3D-печать L3: какой длины может быть шланг между клапаном и шприцем и где находится датчик.
* Сбор данных L4: рецепт и кривые, на которых построены сотни циклов; три отмеченные ситуации — нормальная, закрытая, пустая.

**ЗАПОЛНИТЕ САМИ (KAARDISTA ISE), в конце.**
* Репозиторий Git и тег:
* Числа, предоставленные этой лабораторией, в единицах:
* Что бы мы сделали по-другому:
* Что следует знать перед началом работы следующей лаборатории:

### Обратная связь
