Dennel04/data-acquisition-course/study-ru/session-02.10.26.md

# Сессия 02.10.26 — журнал работы (личные заметки, не для оценки)

Записал Claude по ходу сессии, чтобы продолжить работу потом. Оценочные
цифры, README и дневник (Arenduspäevik) студент пишет сам — здесь только
технический журнал, что и почему менялось.

## Установка на этом ноутбуке

| Что | Где / как |
|---|---|
| mg400-base (с нашими правками) | `~/tools/mg400-base`, ветка `lab-jog`, форк https://github.com/Dennel04/mg400-base |
| venv mg400-base | `~/tools/mg400-base/.venv` (Python 3.14) |
| Запуск сервера робота | `cd data-acquisition/lab1/data && ~/tools/mg400-base/.venv/Scripts/mg400 --z-floor -105 serve --locations ../src/python/locations.json` → http://127.0.0.1:8000 |
| PlatformIO (прошивка Atom) | `~/AppData/Roaming/Python/Python314/Scripts/pio.exe`, в `src/firmware`: `pio run -t upload --upload-port COM4` |
| Atom | COM4 (номер может смениться) |
| MG400 | 192.168.1.6, LAN1 |
| Python пакеты | pyserial, requests (pip --user) |

Адрес сервера в скриптах — `127.0.0.1`, не `localhost` (Windows сначала
пробует IPv6: +200 мс на каждый запрос).

## Стенд на конец сессии

- Под стеклом коробка. **Пол Z = −105, ниже нельзя.** Стекло лежит на коробке,
  присоска касается его на Z ≈ −103. Рабочая точка X 259, Y 27, R ≈ −72.
- Коробка насоса «тупая» (DO2 = всасывание, DO1 = выдув — проверено).
- Ноль датчика хранится в прошивке (NVS). Последний: 94,82 кПа абсолютного.
  Дрейф ~3 кПа за 1,5 ч → перед тестами `logger.py --zero` при открытой присоске.

## Что сделано (по порядку) и почему

1. **logger.py падал при выдёргивании USB** с включённым насосом
   (`SerialException` на Windows) → ловим, насос выкл.
2. **pick_cycles.py / analyze_run.py / hold_test.py / pick_in_place.py / grip.py** —
   скрипты захвата, удержания и анализа (пуски/мин, время работы, доля времени).
3. **mg400-base страница**: кнопки шага (±0.5…10), рабочий Sync, поле Z floor,
   ползунки двигают руку при отпускании, пустые поля точки не становятся 0.
4. **Защита от упоров** (`kinematics.py`): обратная кинематика MG400 (подогнана
   по позам этого робота, 0,01°; совпадает с YCL0209/mg400-workspace), пределы
   J1 ±160, J2 −25…85, J3 −25…105, параллелограмм J3−J2 ≤ 60; запас 2°.
   Рука останавливается перед упором; кнопка «Recover from limit».
   Тревоги сегодня: 34 (J3 = 105° на Z −148 при радиусе 222), 73 (параллелограмм,
   радиус < ~195 мм на Z −16), 85 (аварийная кнопка).
5. **Atom перезагружался при каждом открытии порта** (DTR/RTS) и брал ноль из
   того, что в шланге (−62 кПа стало «0») → порт открывается без сброса +
   прошивка хранит ноль в NVS, при загрузке принимает новый только в ±2 кПа.
6. **Сторож 500 мс в отдельном потоке**; **HTTP к насосу через поток-отправитель**
   (чтение Atom больше не ждёт сеть). USB-тест: насос выкл. через 29 мс (было 1,6 с).
7. **Прошивка: команды режима запускают насос сразу**; пауза 15 с и лимит пусков/мин
   только для автоматических подкачек полосы (иначе блокировались выдув и захват).
8. **approach_and_grip** (`grip.py`, `pick_in_place.py --approach`): вниз до пол+5 мм,
   вакуум, медленно до касания (стоп по давлению ≤ −25), Atom выключает насос на −60.

## Результаты тестов (CSV в `data-acquisition/lab1/data/`, имена `*_02.10.26.csv`)

| Тест | Файл | Итог |
|---|---|---|
| Удержание 120 с в воздухе (Atom) | `lab1_ownbox_hold_air_02.10.26.csv` | −77 → −44 кПа, 0 подкачек |
| Удержание 60 с, прошивка 2 | `lab1_ownbox_hold_air_fw2_02.10.26.csv` | −81 → −57 кПа, доля 6,9 % |
| Перезагрузка Atom при вакууме | (в выводе) | −67,3 → −66,7, ноль `stored` |
| USB выдернут | `lab1_usb_unplug_fw2_02.10.26.csv` | насос выкл. через 29 мс |
| 10 захватов (насос принудительно) | `lab1_pick10_fw3_02.10.26.csv` | 10/10, доля 45 % |
| 10 захватов с подходом | `lab1_approach_pick10_02.10.26.csv` | 10/10, касание −102,8…−103,0, доля 29 % |
| Утечка на столе (не на весу) | `lab1_ownbox_glass_lift_band60_02.10.26.csv` | −65 → 0 за ~3,5 с (на весу держится) |

Анализ любого прогона: `python analyze_run.py ../../data/<файл>.csv`.

## Что осталось до защиты 06.10

См. ответ в чате 02.10 — кратко:
1. README: KAARDISTA ISE разделы, ответы по частям, дневник (своими словами;
   две записи за 13.09 и 02.10 добавил Claude — переписать), `pump_control.md`
   дополнить сегодняшними числами.
2. Выдув с остановкой по давлению — нужна заглушка на шланг.
3. Спектры в `notebooks/` (Pa/LSB, пики с именами, ≥2 подтверждены отключением).
4. Буква: Atom → станция (вместе со Smart Solutions).
5. Битая картинка `docs/lab1_drawio_tark_kast.png` — экспорт из draw.io.
6. Тег `data-acquisition-lab1` в конце.
7. (По желанию) защита «насос работает N с без вакуума → стоп».

## Правила работы с роботом (от студента)

- Мои движения: медленно (2–5 %), шагами; ниже пола никогда; перед движением
  и включением насоса — предупредить одной строкой и дождаться «да».
- Не прижимать к столу/коробке и не включать робота прижатым.
