Dennel04/data-acquisition-course/data-acquisition/lab1/docs/pump_control.md

# Pump control — измерения

## Финальный статус Lab 1

Записи до 13.09.26 ниже сохраняют промежуточное состояние и результаты,
которые были верны на дату измерения. Для итогового состояния Lab 1
используется раздел **02.10.26 — Полная проверка «умной коробки» на роботе**:
рабочая полоса **off −60 / on −40 кПа**, USB unplug → pump off **29 мс**,
два реальных прогона по **10/10** захватов и duty cycle **45,2 % / 29,2 %**.
Выдув проверен как импульс освобождения 20 раз; отдельный capped blow test,
по подтверждению преподавателя, не требуется.

Максимальное непрерывное время работы насоса и более длинный сравнительный
hold test остаются возможными улучшениями, а не незакрытыми критериями Lab 1.

## 12.09.26 — Targa kasti logi (часть 3, ACU2-B заводской "умный" ящик)

**Метод:** T-отвод в выходную трубку ACU2-B, присоска руками прижата к
стеклу, трубка целая. Насос запущен **одной** командой всасывания через
CLI (`mg400 pump suck`) — дальше ACU2-B управляет собой сам, руки от
присоски и CLI убраны на всё время лога. Логировал `python/logger.py`
(`--mode off --dry-run` — Atom только слушает давление, ничего сам не
решает и не шлёт в mg400-base). Сырые данные: [`data/lab1_smartbox_acu2b_12.09.26.csv`](../data/lab1_smartbox_acu2b_12.09.26.csv).

**Параметры лога:** 35800 строк, 358.0 с (5.97 мин), частота подтверждена
~100 Гц (соответствует части 2 задания: 10мс цикл).

**Обнаруженные переключения** (сглаживание скользящим средним по 15
отсчётам, порог значимого перепада — 3 кПа, чтобы не ловить ADC-шум):

| t, мс | p, кПа | Событие |
| :--- | :--- | :--- |
| 1 567 574 | -4.23 | старт (насос ещё не тянул) |
| 1 571 724 | -91.51 | насос дотянул до предела и встал |

Дальше — **ровно плоская линия** ещё ~353 секунды. Повторного включения
насоса за оставшееся время лога не было ни разу.

## Пять чисел (по итогам этого теста)

| Величина | Значение | Комментарий |
| :--- | :--- | :--- |
| **väljalülitusrõhk** (давление выключения) | **≈ -91.5 кПа** | надёжно, один явный переход |
| **sisselülitusrõhk** (давление включения) | **не зафиксировано** | насос ни разу не включился повторно за 5.97 мин — утечка через присоску практически нулевая на этом окне теста, порог включения не достигнут |
| **pumba tööaeg** (время работы насоса) | **~4.2 с** | время набора вакуума от старта до предела |
| **seisuaeg** (время простоя) | **≥ ~353 с** | нижняя граница снизу, не точное число — тест закончился раньше, чем случился повторный цикл |
| **käivitusi minutis** (включений в минуту) | **≈ 0** | за это конкретное окно теста |

**Вывод:** это валидный результат, не ошибка измерения — присоска на
стекле держит настолько хорошо, что за почти 6 минут ACU2-B ни разу не
пришлось перезапускать насос. Короткоцикличности ("lühitsükkel") в этом
сценарии нет и близко — совсем другая картина ожидается в сценарии
"napp õhus" (присоска в свободном воздухе, максимальная утечка), который
всё ещё предстоит измерить для части 4.

**Дальше:**
- Если для отчёта нужна и цифра sisselülitusrõhk — либо логировать
  дольше (пока утечка сама не дотянет до порога), либо намеренно
  чуть приподнять присоску (контролируемая небольшая утечка), чтобы
  спровоцировать повторный цикл — не обязательно по заданию, но полезно
  для полноты картины.
- Часть 4 (собственный ящик): три сценария holding-теста (napp klaasil /
  napp õhus / voolik korgiga) ещё предстоят — это уже с командным
  MG400-ящиком, не с ACU2-B.

## 12.09.26 — Holding-тест, собственный MG400-ящик, сценарий 1: napp klaasil

**Метод:** T-отвод в трубку вашего (обычного, не ACU2-B) пумп-бокса,
присоска руками на стекле. Вакуум включён вручную (кнопка на ящике /
`mg400 pump suck`) до максимума, затем выключен вручную в момент пика —
дальше просто логировали пассивную утечку до возврата к атмосфере, без
дальнейшего вмешательства. Логировал `python/logger.py --mode off
--dry-run`. Сырые данные: [`data/lab1_ownbox_glass_12.09.26.csv`](../data/lab1_ownbox_glass_12.09.26.csv).

**Параметры лога:** 39829 строк, 398.3 с (6.64 мин), ~100 Гц подтверждено.

| Событие | t, мс | p, кПа |
| :--- | :--- | :--- |
| Старт (до включения) | 1 610 491 | -1.12 |
| Насос выключен (пик вакуума) | 1 641 651 | **-83.06** |
| Восстановилось до атмосферы (≥ -2 кПа) | 1 952 331 | -1.97 |

**Числа для этого сценария:**

| Величина | Значение |
| :--- | :--- |
| Достигнутый максимум вакуума | **-83.06 кПа** |
| Время работы насоса (до пика) | **~12–16 с** |
| Время утечки обратно до атмосферы (простой) | **310.7 с (~5.18 мин)** |

**Вывод:** в отличие от теста с ACU2-B (где утечка вообще не успела
проявиться за ~6 минут), здесь присоска на стекле **полностью
восстановилась** до атмосферного давления за разумное время — значит на
этом конкретном ящике/присоске утечка через контакт присоска-стекло
заметно больше, чем через ACU2-B. Это даёт полную кривую утечки, из
которой можно выбирать полосу (on/off kPa) и минимальное время простоя
для части 4, а не только нижнюю границу, как в тесте с ACU2-B.

**Дальше:** сценарии 2 (napp õhus — присоска в свободном воздухе) и 3
(voolik korgiga — трубка с заглушкой) ещё предстоят, той же методикой.

## 12.09.26 — Holding-тест, собственный MG400-ящик, сценарий 2: napp õhus

**Метод:** та же T-схема, но присоска висит в свободном воздухе, ничего
не касается (максимальная негерметичность, полная противоположность
сценарию 1). Вакуум включён вручную, оставлен работать дольше обычного,
пока давление не вышло на плато (насос не может тянуть глубже против
свободно текущего воздуха), затем выключен вручную. Логировал
`python/logger.py --mode off --dry-run`. Сырые данные:
[`data/lab1_ownbox_air_12.09.26.csv`](../data/lab1_ownbox_air_12.09.26.csv).

**Параметры лога:** 9376 строк, 93.75 с.

| Событие | t, мс | p, кПа |
| :--- | :--- | :--- |
| Плато (последние ~5с перед выключением) | — | среднее **-12.4 кПа** (шум -9…-15) |
| Насос выключен (пик) | 46 914 | **-15.46** |
| Восстановилось до атмосферы (≥ -2 кПа) | 63 874 | -1.97 |

**Числа для этого сценария:**

| Величина | Значение |
| :--- | :--- |
| Максимум вакуума, который насос вообще способен вытянуть против открытого конца | **≈ -12…-15 кПа** (плато, не растёт дальше) |
| Время утечки обратно до атмосферы (простой) | **17.0 с** |

**Вывод:** ровно то, что и ожидалось — на порядок мельче максимум (-15
против -83 кПа на стекле) и на порядок быстрее восстановление (17с
против 310.7с). Это подтверждает, что именно контакт присоска-поверхность
определяет герметичность системы, а не сам насос/клапаны — совпадает с
выводом из части 4 задания про важность плотного прилегания присоски.
Отдельно интересно, что даже здесь давление **не возвращается к 0
мгновенно** — трубка и сам насос дают заметную (17с) постоянную времени
сами по себе, это нижний предел скорости даже при полностью открытом
конце.

**Дальше:** сценарий 3 (voolik korgiga — трубка с заглушкой) — ожидаем
самую медленную утечку из всех трёх (или вообще без неё).

## 12.09.26 — Holding-тест, собственный MG400-ящик, сценарий 3: voolik korgiga

**Метод:** та же T-схема, но вместо присоски на конце трубки — глухая
заглушка (нулевая утечка в идеале). Вакуум включён вручную до максимума,
выключен вручную в момент пика, дальше просто наблюдали. Логировал
`python/logger.py --mode off --dry-run`. Сырые данные:
[`data/lab1_ownbox_capped_12.09.26.csv`](../data/lab1_ownbox_capped_12.09.26.csv).

**Параметры лога:** 31193 строки, 311.9 с (5.2 мин).

| Событие | t от старта, с | p, кПа |
| :--- | :--- | :--- |
| Насос выключен (пик вакуума) | 18.3 | **-83.34** |
| Держится почти без изменений | ~18.3–48 | -80…-81 |
| **Резкий скачок** (~5 с) | ~48–53 | -81.2 → **-59.6** |
| Новое плато, стабильно до конца лога | 53–293.6 (конец) | -57…-60 (дрейф в среднем -57.4 за последние ~5с) |

**Важная особенность:** в отличие от плавной экспоненциальной утечки
(как в сценарии 1), здесь была **одна резкая ступенька** примерно через
30 секунд после выключения — команда подтвердила, что заглушку/трубку
никто намеренно не трогал, возможна лёгкая случайная задёвка или
микро-сдвиг заглушки, а не постепенная утечка. После скачка система
снова стабилизировалась и держала новое плато без дальнейшего дрейфа
(~240 секунд наблюдения после скачка).

**Числа для этого сценария:**

| Величина | Значение |
| :--- | :--- |
| Достигнутый максимум вакуума | **-83.34 кПа** (практически идентично сценарию 1 со стеклом, -83.06) |
| Время до ступеньки (условно "первая фаза простоя") | **~30 с** практически без потерь |
| Итоговое плато после ступеньки | **≈ -57…-60 кПа**, стабильно ещё ≥240 с без дальнейшего дрейфа |
| Полного возврата к атмосфере за 5.2 мин теста — не было | — |

**Вывод:** сама пневматика (заглушка на трубке, без задействования
присоски/стекла) держит вакуум почти идеально — глубина максимума
совпала со сценарием "стекло" (-83 против -83), и **первые 30 секунд**
после выключения потерь почти нет. Разовая ступенька выглядит как
механическая случайность (небольшое смещение), а не характеристика
самой системы, и её стоит отметить как artефакт измерения, а не как
"утечку" в физическом смысле. Если её не считать, "чистая" пневматика
(без датчика утечки через присоску) держит вакуум практически без
потерь — что подтверждает вывод сценария 2: **вся утечка в системе
определяется именно контактом присоска–поверхность**, а не насосом,
клапанами или трубками.

## Итоговое сравнение всех трёх сценариев

| Сценарий | Макс. вакуум | Время работы | Время/поведение простоя |
| :--- | :--- | :--- | :--- |
| 1. napp klaasil (стекло) | -83.06 кПа | ~12–16 с | полный возврат к атмосфере за 310.7 с |
| 2. napp õhus (воздух) | -12…-15 кПа (плато, насос не тянет глубже) | — (мгновенно на плато) | полный возврат за 17.0 с |
| 3. voolik korgiga (заглушка) | -83.34 кПа | ~18 с | почти без потерь первые 30с, разовая ступенька к -58, дальше стабильно ≥240с |

Это даёт полную картину для выбора реальной полосы (on/off kPa) и
минимального времени простоя в части 4: система в целом герметична
(сценарий 3), реальная присоска на стекле даёт умеренную, предсказуемую
утечку (сценарий 1), а открытый конец — это заведомо нерабочий крайний
случай (сценарий 2), с которым в проде сталкиваться не должны.

## 13.09.26 — Выбор реальной полосы on/off (часть 4, решение)

Посчитано напрямую из трёх CSV выше (`data/lab1_ownbox_*_12.09.26.csv`) —
не на глаз, а по реальным точкам пересечения порогов.

### Выбранные числа

| Параметр | Значение | Название в коде (`logger.py --*`) |
| :--- | ---: | :--- |
| Väljalülitusrõhk (off, цель, глубокий вакуум) | **-75 кПа** | `--off-kpa -75` |
| Sisselülitusrõhk (on, перезапуск) | **-40 кПа** | `--on-kpa -40` |
| Seisuaja alampiir (min-off-time) | **15 с** | `--min-off-ms 15000` |
| Käivitusi minutis, ülempiir (max-cycles/min) | **4/мин** | `--max-cycles-per-min 4` |

### Почему именно так — по реальным точкам пересечения

Из данных: время, за которое давление после пика возвращается (слабеет)
обратно за порог, если считать от момента максимального вакуума:

| Сценарий | Проходит -75 кПа (off) | Проходит -40 кПа (on) |
| :--- | :--- | :--- |
| napp klaasil | +14.95 с после пика (-83.06) | **+102.21 с** после пика |
| napp õhus | никогда (максимум всего -15.46 кПа) | никогда |
| voolik korgiga | +33.19 с после пика (-83.34) | **никогда за 312с лога** (плато на -57…-58) |

**Väljalülitusrõhk = -75 кПа**: с запасом ниже максимума, который реально
достигается и на стекле (-83.06), и с заглушкой (-83.34) — насос не должен
каждый раз выжимать абсолютный максимум, это лишний износ. При этом **-75
кПа физически недостижимо в сценарии napp õhus** (там максимум -15.46) —
то есть в открытом воздухе насос никогда не получит команду "выключиться
по достижению цели": он просто продолжит работать непрерывно, а не будет
дёргаться туда-сюда. Это и есть защита от короткого цикла ("lühitsükkel"),
которую явно требует задание для этого сценария — просто она работает не
через `min-off-time`, а через сам выбор глубины `off-kpa`, недостижимой в
этом крайнем случае.

**Sisselülitusrõhk = -40 кПа**: на стекле насос перезапускается только
через **~102 с** после выхода на пик (реальный цикл — раз в ~2 минуты) —
далеко от коротких циклов. В сценарии с заглушкой (герметичная система)
за все 312с лога давление вообще не доходит до -40 (держится на -57…-58) —
то есть на герметичной трубе перезапуска не будет вовсе в пределах
разумного времени. Оба "хороших" сценария дают частоту циклов, на порядки
ниже установленного потолка в 4/мин.

**Seisuaja alampiir = 15 с**: с запасом меньше, чем самый быстрый реальный
интервал перезапуска (~102с на стекле) — то есть в нормальной работе он
вообще не является узким местом, а просто подстраховка от дребезга/шума
прямо у порога (аналогично найденной ранее коммутационной помехе —
`sensor_choice.md`).

**Käivitusi minutis = 4/мин**: соответствует `min-off-time=15с` (60/15=4)
как верхний потолок — если что-то пошло не так и система реально начала
дёргаться чаще этого, прошивка должна остановить помпу и показать причину
на экране (см. псевдокод части 4 в README).

### Необязательное улучшение после Lab 1 — max continuous pump runtime

**napp õhus (открытый воздух) не даёт короткого цикла, но даёт
непрерывную бесконечную работу насоса** — раз цель (-75 кПа) физически
недостижима, давление никогда не пересечёт väljalülitusrõhk, значит и
условие "выключить" никогда не сработает через полосу давления. Пять
чисел выше (полоса + seisuaeg + käivitusi/min) сами по себе **не защищают
мотор от бесконечной непрерывной работы** в этом крайнем случае — только
от частого дёрганья. Рекомендация (за рамки того, что явно просит
задание, но важно для реальной защиты мотора и для защиты работы):
добавить отдельный **максимальный непрерывный час работы насоса**
(например 30-60с), после которого прошивка сама переходит в `pump: 0` с
причиной "цель недостижима" на экране — независимо от полосы давления.
Пока не реализовано в `pump_logic.cpp`; это зафиксировано как возможное
будущее улучшение, а не обязательный незакрытый критерий Lab 1.

### Состояние на 13.09.26 перед финальным тестом 02.10.26

- ~~Прогнать `python/logger.py` без `--dry-run`~~ — сделано, см. ниже.
- ~~Десять циклов "робот берёт стакан" с записью duty cycle~~ — на
  13.09.26 ещё не были выполнены; закрыто 02.10.26 двумя реальными
  прогонами 10/10, см. финальный раздел ниже.

## 13.09.26 — Автономный прогон (часть 4, `logger.py` без `--dry-run`)

**Перед прогоном найден и починен реальный пробел:** `logger.py` принимал
`--min-off-ms`/`--max-cycles-per-min` как аргументы, но **никогда не
отправлял их прошивке**, а `main.cpp` ни разу не вызывал
`pumpController.setSafetyLimits()` — то есть защита от короткого цикла и
потолок циклов/мин существовали только в `pump_logic.h` как код, но не
были реально подключены. Добавили новую команду протокола
`{"cmd":"limits","minOffMs":...,"maxCyclesPerMin":...}` (парсинг в
`comms.cpp`, обработка в `main.cpp`), `logger.py` теперь шлёт её при
старте вместе с `band`/`mode`. Прошивка перекомпилирована и перезалита на
Atom (COM6) перед тестом.

**Электрическая диагностика перед этим же тестом:** коробка была
переключена с ручного режима (кнопка) на управление через DO-линии
MG400 — обнаружилось, что она стояла в положении **MANUAL**. После
переключения DO-управление подтверждено рабочим (глубина вакуума через
API совпала с ручным тестом, ~-75...-77 кПа).

**Запуск:**
```
python logger.py --port COM6 --on-kpa -40 --off-kpa -75 \
  --min-off-ms 15000 --max-cycles-per-min 4 --mode suction \
  --csv-out data/lab1_autonomous_run_13.09.26.csv
```
(без `--dry-run` — прошивка Atom сама решает через `pump_logic.h`,
`logger.py` только транслирует её решение в DO MG400 через `mg400-base`.)

**Длительность:** 143.6 с, 14361 строк, присоска на стекле (та же
сборка: коробка → тройник → датчик + захват робота).

**Результат — 8 полных циклов, все числа прямо из CSV:**

| Величина | Значение |
| :--- | :--- |
| Время работы насоса за цикл | ~1.52–1.60 с (стабильно) |
| Время простоя за цикл | **ровно 15000 мс каждый раз** — `min-off-time` реально соблюдается прошивкой |
| Давление на выключении | стабильно -75.0…-75.9 кПа — совпадает с целью `off-kpa=-75` |
| Давление на включении | от +1.7 до -0.6 кПа (то есть уже почти полная атмосфера) |
| Duty cycle (общее время работы / общее время теста) | **~9.7%** (14.0с работы из 143.6с) |
| Частота циклов | **3.34 цикл/мин** (8 циклов за 143.6с) |

**Важная честная находка:** система (через тройник, включая плечо к
захвату робота) **теряет вакуум с -75 до почти атмосферы менее чем за
15 секунд** — на порядок быстрее, чем в исходном holding-тесте части 4 на
той же присоске и стекле (там -75 кПа проходилось только через 102с, а
полный возврат к атмосфере занимал 310.7с). То есть **реальная утечка в
собранной системе (с плечом к роботу) заметно больше**, чем в упрощённом
прямом тесте без робота — вероятно, лишняя точка соединения (тройник или
сам захват) подсасывает воздух. Это согласуется с более ранним
наблюдением в этой же сессии (после подключения плеча робота вакуум
через DO сначала вообще не доходил до цели, пока не проверили
соединения).

**Частота циклов (3.34/мин) осталась ниже потолка `max-cycles-per-min=4`**
— то есть защита "cycle-limit" ни разу не сработала за этот прогон,
хотя рабочая частота идёт довольно близко к пределу. Отдельно замечено:
реализация окна подсчёта циклов в `pump_logic.h` — не настоящее
скользящее окно, а "перезапускается, если прошло больше 60000мс с
последнего сброса" — при частоте, близкой к пределу, это может занижать
реальный счётчик циклов относительно честного 60-секундного скользящего
окна. Не мешало этому конкретному прогону, но стоит знать для защиты.

## 13.09.26 — Уточнение: утечка была не в системе, а в способе теста

После автономного прогона выше возникла гипотеза, что лишняя утечка — в
плече тройника к захвату робота. Проверили напрямую: включили вакуум
через API и **подняли стекло присоской в воздух** (настоящий захват, а
не просто прижатое к столу стекло, как было в автономном прогоне выше).

**Результат: давление держалось стабильно -76…-79 кПа все 30 секунд
наблюдения, без малейшего признака утечки.**

**Вывод:** утечка в автономном прогоне была **артефактом способа
тестирования** — стекло лежало на столе, присоска была прижата не под
идеальным углом/не полным контактом, а не проблемой самой пневматической
сборки (тройник, захват робота, сама трубка — герметичны, как и
предполагалось). Реальная утечка в контакте присоска-поверхность —
это ровно то же самое явление, что и в исходном сценарии части 4
"napp klaasil" (там присоска тоже была прижата вручную к горизонтальному
стеклу, а не поднимала его) — то есть это уже известный, ожидаемый режим
работы, а не новый дефект.

**Практический вывод для части 4:** при реальном захвате (10 циклов
"робот берёт стакан") утечки, скорее всего, не будет — контакт при
настоящем подъёме плотнее, чем при тесте с лежащим стеклом. Полосу
-40/-75 менять не требуется.

**Честная оговорка — это ещё НЕ полноценное сравнение с targa kast
(ACU2-B, часть 3):** там тест длился почти 6 минут (358с) без единого
цикла. Здесь проверено только **30 секунд** (~8% той длительности) —
достаточно, чтобы опровергнуть гипотезу "утечка в тройнике/захвате", но
недостаточно, чтобы утверждать "держит так же долго, как умный ящик".
Медленная микро-утечка (как в исходном "napp klaasil" тесте, где
утечка проявлялась только через десятки секунд) могла бы не успеть
проявиться за 30с. **Необязательное продолжение сравнения:** повторить
тот же тест (стекло поднято присоской в воздухе), но логировать несколько
минут, ближе к длительности теста ACU2-B. В рамках Lab 1 оно не выполнялось.

**Вывод:** автономное управление подтверждено полностью рабочим
(прошивка сама решает, компьютер только транслирует в DO) — ключевое
требование части 4 выполнено. Но выбранная полоса (-40/-75), хорошая на
эталонных кривых части 4, даёт на **реальной собранной системе** более
частые циклы, чем ожидалось (3.34/мин вместо расчётных <1/мин) — если
для защиты/демо нужна более редкая работа насоса, следующий шаг — найти
и устранить утечку в плече робота, а не только перенастраивать полосу.

**Статус этой записи:** это вывод по состоянию на 13.09.26. Рабочий выбор
−75 кПа и перечисленные физические TODO заменены итоговыми результатами
02.10.26 ниже; исходные измерения и промежуточный вывод сохранены.

## 02.10.26 — Полная проверка "умной коробки" на роботе (часть 4)

*Измерения — команда на стенде, 02.10.26; текст записал Claude по логам.
Подробный технический журнал сессии: `study-ru/session-02.10.26.md`.*

### Стенд
- Тот же MG400-ящик (DO2 = всасывание, DO1 = выдув — проверено импульсами:
  всасывание даёт вакуум, выдув — давление).
- Стекло лежит на коробке-подставке, **пол робота Z = −105 мм** (ниже нельзя),
  присоска касается стекла на Z ≈ −103, точка X 259 / Y 27.
- Atom: прошивка с хранимым нулём (см. ниже), `logger.py` / `hold_test.py` /
  `pick_in_place.py` из `src/python/`. Анализ: `python analyze_run.py <csv>`.

### Что пришлось исправить, прежде чем числа стали честными
| Проблема | Как проявилась | Исправление |
|---|---|---|
| Atom перезагружался при каждом открытии USB-порта (DTR/RTS) и брал ноль из того, что в трубке | стекло висит на −62 кПа, после переподключения экран показывает 0 | порт открывается без сброса (`open_atom`); прошивка хранит ноль в NVS и при загрузке принимает новый только в пределах ±2 кПа (`zero.h/.cpp`), обнуление командой `{"cmd":"zero"}` / `logger.py --zero` |
| Выдернутый USB ронял `logger.py` с включённым насосом | исключение `SerialException` | ловим → насос выкл. |
| Сторож 500 мс ждал вместе с «зависшим» чтением, HTTP к насосу блокировал чтение | насос выкл. через 1,6 с; ложные срабатывания сторожа | сторож — отдельный поток; команды насосу — отдельный поток-отправитель; адрес `127.0.0.1` вместо `localhost` (210 мс → 1,2 мс на запрос) |
| Пауза 15 с и лимит 4 пуска/мин блокировали и **командные** пуски | выдув не отпустил стекло; 3-й захват за минуту отклонён | смена режима командой запускает насос сразу; пауза и лимит — только для автоматических подкачек полосы (`pump_logic.h`) |
| Полоса −75 кПа недостижима на этом стенде | насос работал 100 % времени (макс. −67 кПа на столе) | рабочая полоса **off −60 / on −40 кПа** |

### Результаты
| Тест | Файл (`data/`) | Число |
|---|---|---|
| Порог −75 на столе | `lab1_ownbox_glass_lift_02.10.26.csv` | макс. −67,3 кПа → насос 100 % времени: −75 недостижимо |
| Стекло лежит на столе, насос выкл. | `lab1_ownbox_glass_lift_band60_02.10.26.csv` | −65 → 0 кПа за ~3,5 с: присоска на лежащем стекле течёт |
| Стекло поднято, насос выкл. | `lab1_ownbox_release_test_02.10.26.csv` | −77,9 → −62,1 кПа за 10 с: на весу держит (скачок −78 → −64 за 0,25 с — клапан коробки) |
| **Удержание в воздухе 120 с, решает Atom (−60/−40)** | `lab1_ownbox_hold_air_02.10.26.csv` | −77 → −44 кПа, **0 подкачек** за 120 с; доля работы 12,3 % (только захват и спуск) |
| **Удержание 60 с, прошивка с хранимым нулём** | `lab1_ownbox_hold_air_fw2_02.10.26.csv` | −81 → −57 кПа, 0 подкачек; доля 6,9 %; 100,0 Гц |
| Перезагрузка Atom при −67 кПа в трубке | (вывод скрипта) | до −67,3, после −66,7 кПа, источник нуля `stored` |
| **USB выдернут, старая логика** | `lab1_usb_unplug_02.10.26.csv` | насос выкл. через ~1,6 с после последней строки |
| **USB выдернут, новая логика** | `lab1_usb_unplug_fw2_02.10.26.csv` | последняя строка 18:25:30,204 → DO выкл. 18:25:30,233: **29 мс** (требование ≤ 500 мс) |
| **10 захватов** (захват с насосом, в воздухе решает Atom) | `lab1_pick10_fw3_02.10.26.csv` (+ `.events.csv`) | **10/10**, цикл 14,6–14,9 с, захват до −50 кПа за 0,20–0,27 с, 21 пуск, **доля работы насоса 45,2 %** |
| **10 захватов с подходом** (вакуум за 5 мм до пола, стоп по касанию, Atom выключает насос) | `lab1_approach_pick10_02.10.26.csv` (+ `.events.csv`) | **10/10**, касание на Z −102,8…−103,0, 0,67–0,73 с после включения вакуума, насос выкл. на −54…−65 кПа, **доля работы насоса 29,2 %** |
| Первая попытка 10 захватов (старая прошивка) | `lab1_pick10_02.10.26.csv` | остановилась на 3-м цикле — так нашли блокировку командных пусков |

### Пять чисел — итог 02.10.26 (собственный ящик, реальная собранная система)
| Число | Значение |
|---|---|
| väljalülitusrõhk (выключение) | **−60 кПа** (было −75: на этом стенде недостижимо) |
| sisselülitusrõhk (включение) | **−40 кПа** |
| seisuaja alampiir (мин. пауза) | **15 с** — только для автоматических подкачек |
| käivitusi minutis (макс.) | **4/мин** — только автоматические; при удержании в воздухе фактически 0 |
| pumba töötsükkel 10 võtmise ajal | **45 %** (захват с насосом) / **29 %** (захват с подходом) |

### Выдув и заглушка
Отдельный тест «выдув сам останавливается по давлению с заглушкой на трубке»
**не проводился — заглушка не нужна: преподаватель подтвердил, что этот тест не требуется**: в этой системе
выдув используется только как короткий импульс отпускания стекла
(0,5 с, +10…+18 кПа), и он проверен 20 раз (10/10 в обоих прогонах
захватов), стекло отпускалось каждый раз. Логика остановки выдува по
давлению в прошивке та же, что для всасывания, с обратным знаком
(`pump_logic.h`, режим `blow`, полоса `on`/`off`).

### Наблюдения
- Дрейф нуля датчика: 97,91 → 94,82 кПа абсолютного за ~1,5 ч (погода так быстро
  не меняется → датчик/питание 5 В). Перед тестами — `logger.py --zero` с открытой
  присоской.
- Короткий свист ~1 с при прикреплении — норма (присоска садится); длинный свист
  был только когда насос тянул через открытую присоску (стекло упало) — защиты
  «насос работает N с без вакуума → стоп» пока нет.
- Программы MG400 со всеми правками страницы (кнопки шага, защита от упоров J3 и
  параллелограмма, Recover): форк https://github.com/Dennel04/mg400-base, ветка `lab-jog`.
