Dennel04/data-acquisition-course/data-acquisition/lab2/docs/falstad_first_version.txt

<cir f="1" ts="0.000005" ic="10.20027730826997" cb="57" pb="50" vr="5" mts="5e-11">
  <a x="288 192 432 192" f="0" ma="5" mi="0" ga="100000"/>
  <w x="288 112 288 176" f="0"/>
  <w x="432 192 432 112" f="0"/>
  <r x="288 112 432 112" f="0" r="27000"/>
  <r x="192 112 288 112" f="0" r="10000"/>
  <r x="288 208 288 256" f="0" r="27000"/>
  <g x="288 256 288 304" f="0"/>
  <r x="288 208 192 208" f="0" r="10000"/>
  <R x="192 112 128 112" f="0" wf="0" maxv="0.3251612903225806"/>
  <O x="432 192 496 192" f="0" sc="0"/>
  <R x="192 208 128 208" f="0" wf="0" maxv="0.4"/>
  <x x="96 48 536 48" f="0" si="14" te="Õppejõu MPX5700AP näide, mitte meie mõõtetulemus."/>
  <x x="112 352 416 352" f="0" si="14" te="Ideal op-amp output limits: GND to +5 V (simulation)"/>
  <x x="48 112 95 112" f="0" si="14" te="Vref"/>
  <x x="48 208 95 208" f="0" si="14" te="Vin"/>
</cir>
