Dennel04/data-acquisition-course/data-acquisition/lab1/docs/bom.md

# BOM — заказ на 22.09.26

## Итог: заказ не требуется (нулевой результат, зафиксировано 13.09.26)

Прошлись по всем частям лабы и проверили, чего не хватает на полке в
лаборатории. **Всё нужное для этой лабы физически уже было в наличии** —
датчик (MPX5700AP), макетка, пневматика (трубка, T-фитинги, присоски),
компоненты для MG400 pump box. Отдельный заказ через Mouser на 22.09 не
понадобился.

Датчик: решение части 1 (`docs/sensor_choice.md`) — остаёмся на
MPX5700AP, с числами почему (все альтернативы либо не помещаются в 3.3В
ADC без делителя, либо физически не покрывают нужный диапазон). Значит и
здесь новую деталь заказывать не нужно.

## Что проверить ещё раз перед 22.09 (на случай, если что-то всплывёт)

- Часть 5 (буква): канал с Nutikad Lahendused L1 ещё не согласован
  ("lepitakse kokku esimesel nädalal") — если для него понадобится
  отдельное железо (радиомодуль и т.п.), это может стать единственным
  реальным пунктом заказа. Пока неизвестно, значит рано писать конкретную
  деталь.

  **Уточнение 03.10.26:** канал реализован на том же AtomS3R и через тот же
  USB-C, что и телеметрия давления: **AtomS3R → USB serial → station**.
  Отдельное оборудование не потребовалось, поэтому отдельного заказа для
  этой части не было.
- Если по ходу part 4 (автономный прогон, реальная полоса on/off)
  выяснится, что чего-то не хватает физически — дописать сюда.
