Dennel04/data-acquisition-course/data-acquisition/lab3/atoms3-mudel/stl/atoms3-mudel.stl

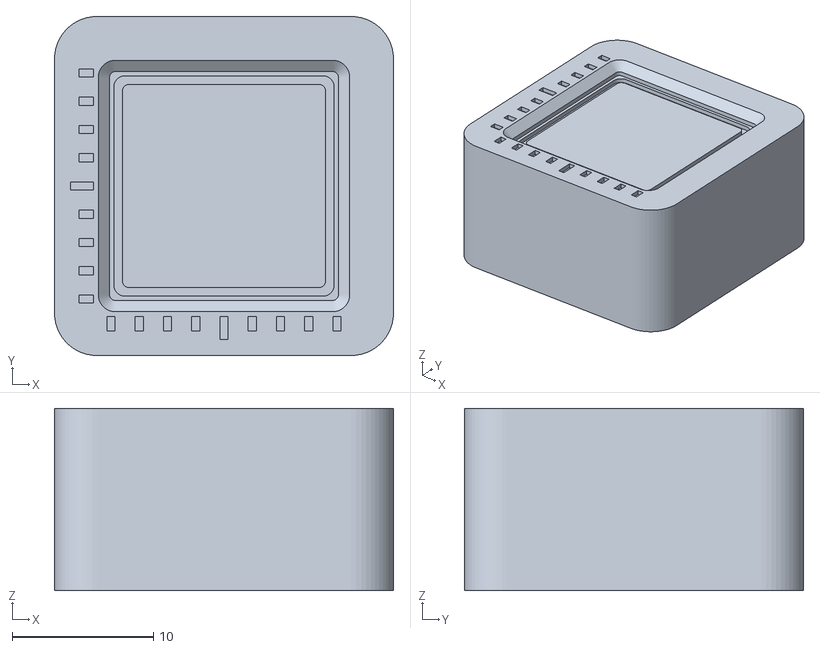
[picture p7: CAD file, 2026-11-13]
data-acquisition/lab3/atoms3-mudel/stl/atoms3-mudel.stl
24.0 x 24.0 x 12.9
