Dennel04/data-acquisition-course/data-acquisition/lab3/tilgaplaat/3mf/tilgaplaat-atoms3-mudel.3mf

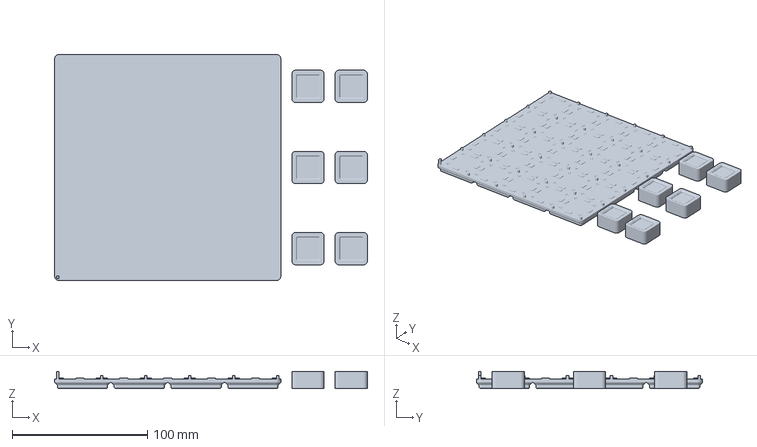
[picture p8: CAD file, 2026-11-13]
data-acquisition/lab3/tilgaplaat/3mf/tilgaplaat-atoms3-mudel.3mf
231.5 x 167.5 x 12.9 mm
