Dennel04/data-acquisition-course/data-acquisition/lab3/tilgaplaat/stl/tilgaplaat-v3.stl

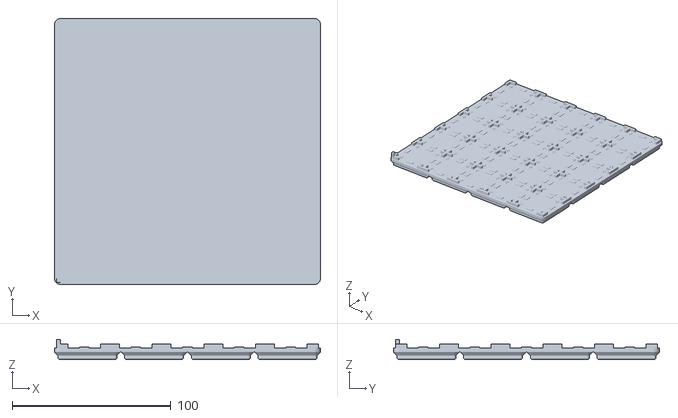
[picture p9: CAD file, 2026-11-14]
data-acquisition/lab3/tilgaplaat/stl/tilgaplaat-v3.stl
167.5 x 167.5 x 12.6
