Dennel04/data-acquisition-course/data-acquisition/lab3/tilgaplaat/v1/tilgaplaat_Lab3_v1.step

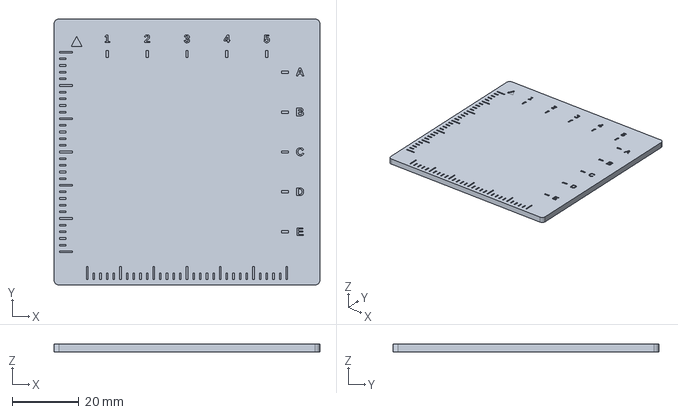
[picture p10: CAD file, 2026-11-14]
data-acquisition/lab3/tilgaplaat/v1/tilgaplaat_Lab3_v1.step
80.0 x 80.0 x 2.40 mm
