Dennel04/data-acquisition-course/data-acquisition/lab3/tilgaplaat/3mf/tilgaplaat.3mf

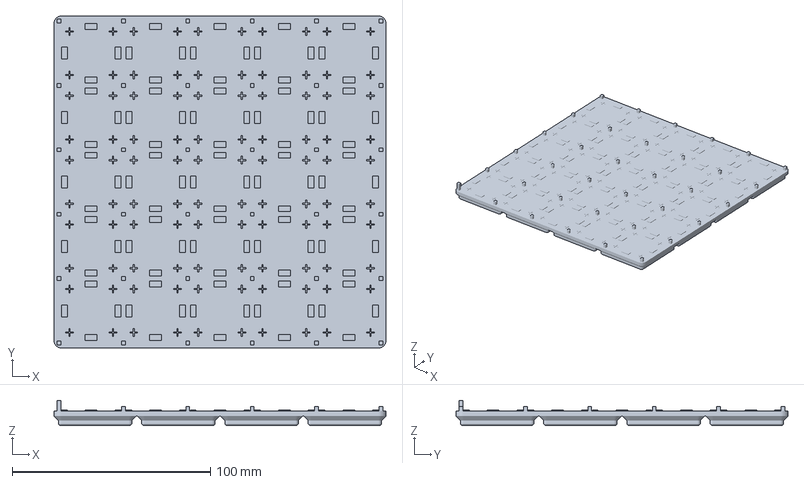
[picture p11: CAD file, 2026-11-13]
data-acquisition/lab3/tilgaplaat/3mf/tilgaplaat.3mf
167.5 x 167.5 x 12.6 mm
