Dennel04/data-acquisition-course/(list of files, cad)

Other CAD files:
data-acquisition/lab3/tilgaplaat/src/da-lab3-tilgaplaat-atoms3-mudel.f3d
data-acquisition/lab3/tilgaplaat/src/da-lab3-tilgaplaat-v3.f3d
data-acquisition/lab3/tilgaplaat/stl/tilgaplaat.stl
data-acquisition/lab3/tilgaplaat/v1/tilgaplaat_Lab3_v1.3mf
data-acquisition/lab3/tilgaplaat/v1/tilgaplaat_Lab3_v1.f3d
data-acquisition/lab3/tilgaplaat/v1/tilgaplaat_Lab3_v1.stl
