Dennel04/data-acquisition-course/data-acquisition/lab2/docs/lm358n_wiring_2026-10-22.md

# LM358N katseskeemi koostamine 22.10.2026

Maksim koostas MB-102 maketeerimisplaadil LM358N DIP-8 katseskeemi. B5K
potentsiomeeter asendas anduri sisendpinget ja B100K määras viitepinge.
MPX5700AP selles katses ei osalenud. See kirjeldus taastab dokumenteeritud
ühendused; see ei anna luba ühendada kontrollimata väljundit G5-ga.

## Allikas ja seos varasemate tulemustega

Algallikas on Maksimi [muutmata Word-fail](sources/lab2-sborka-2026-10-22.docx)
(`lab2 sborka.docx`). Dokumendis on katse kuupäev 22.10.2026; Wordi faili
loomis- ja muutmiskuupäev on 23.10.2026. Lokaalne renderdus ja faili
leheküljearvu metaandmed näitasid 10 lehekülge. Algfaili SHA-256:

`afd4af53a9813d182b921d90b7ea75a33e8c01e8a32de0762e28787fc8d45b64`

Algfaili lõpus on ka vestluse väljavõte. See jääb algallikasse, kuid ei ole
selle juhendi osa ega uus mõõtmistõend. Fotot või ostsillogrammi algfailis ei ole.

Juba avaldatud [mõõtetabel](bench_session.md#22102026--lm358n-katseskeemi-mõõtmised-maksim),
[arvutus](opamp_design.md#22102026--katses-kasutatud-lm358n-võimendusaste-maksim)
ja [komponentide loend](bom.md#22102026--katses-kasutatud-komponendid-maksim)
jäävad tulemuste põhiviideteks. Käesolev juhend lisab paigutuse ja juhtmete
taastamisloendi; algseid mõõteväärtusi ei muudeta. 04.10 ja 11.10 kirjete
teistsugused potentsiomeetri koordinaadid kirjeldavad varasemaid ülesehitusi.

## 1. Viigustik ja maketeerimisplaat

A–E pesad on sama nummerdatud rea piires ühendatud; F–J pesad moodustavad
eraldi rühma. E ja F vahel on keskvahe. Kõrvutised nummerdatud read ei ole
omavahel ühendatud. Kontrolli seda vooluta plaadil pidevusmõõtmisega.

LM358N asub keskvahe kohal ridadel 26–29. Korpuse ülaltvaade ja pin 1
märgis peavad vastama tabelile; viigunumber ei ole maketeerimisplaadi rea number.

| LM358N viik | Pesa | Otstarve |
|---:|---|---|
| 1 | E26 | A väljund, `Vout` |
| 2 | E27 | A inverteeriv sisend, A− |
| 3 | E28 | A mitteinverteeriv sisend, A+ / `Vin` |
| 4 | E29 | Negatiivne toide, selles katses GND |
| 5 | F29 | B mitteinverteeriv sisend, B100K liugur |
| 6 | F28 | B inverteeriv sisend, ühendatud B väljundiga |
| 7 | F27 | B väljund, puhverdatud `Vref` |
| 8 | F26 | Positiivne toide |

Viikude funktsioonid vastavad [LM358 andmelehe PDIP ülaltvaatele, jaotis 4](https://www.ti.com/lit/ds/symlink/lm358.pdf).
Kontrolli enne uut ehitust ka tegeliku komponendi tootjat ja täpset varianti;
ühe perekonna eri variantide elektrilised piirid ei ole samad.

## 2. Toide ja potentsiomeetrite toitesõlm

Paigalda või muuda juhtmeid ainult väljalülitatud USB ja muu toitega.
Jäta G5 esmase pingekontrolli ajal ühendamata.

| Ühendus või element | Algus | Lõpp | Otstarve |
|---|---|---|---|
| Toitejuhe | AtomS3R 5V | H26 | Sama rühm mis LM358 pin 8 |
| Maajuhe | AtomS3R G/GND | D29 | Sama rühm mis pin 4; mõõtmiste ühine maa |
| Toiteharu juhe | J26 | H30 | Viib toite potentsiomeetrite harusse |
| 1 kΩ takisti | I30 | I32 | Potentsiomeetrite toiteharu jadatakisti |

H30 ja I30 on sama sõlm; I32, G32 ja J32 on teine ühine sõlm. Viimane
toidab mõlema potentsiomeetri ülemist otsa. 1 kΩ takisti ei kuulu `Rf/Rref`
võimendussuhtesse ega kaitse G5 sisendit. Selle pingelang ja haru koormus
võivad muuta potentsiomeetrite toitepinget; mõõda sõlme, ära eelda seal 5 V.

## 3. B5K testsisend

B5K viigud asuvad pesades A20, A22 ja A24. Allikas määratleb A22 liugurina;
kontrolli tegeliku potentsiomeetri viike enne ühendamist.

| Juhe | Algus | Lõpp | Otstarve |
|---|---|---|---|
| Alumine ots | B20 | C29 | GND |
| Liugur | B22 | C28 | LM358 A+ testsisend |
| Ülemine ots | B24 | G32 | Takistijärgne toitesõlm |

B5K pööramine muudab `Vin` väärtust. See ei simuleeri iseenesest teadaolevat
rõhku ega määra MPX5700AP tegelikke otspunkte.

## 4. B100K viide ja kanali B puhver

B100K viigud asuvad F44, F46 ja F48; F46 on allikas liugur.

| Juhe | Algus | Lõpp | Otstarve |
|---|---|---|---|
| Alumine ots | G44 | A29 | GND |
| Liugur | G46 | H29 | LM358 B+ ehk pin 5 |
| Ülemine ots | G48 | J32 | Takistijärgne toitesõlm |
| Puhvri tagasiside | H28 | H27 | B− ehk pin 6 ühendatakse B väljundiga pin 7 |

Kanal B töötab pingejärgijana. Kasuta esimese kanali arvutuses mõõdetud
puhverväljundit J27, mitte oletuslikku potentsiomeetri pinget.

## 5. Kanali A tagasiside ja viitetakistid

| Element või juhe | Algus | Lõpp | Otstarve |
|---|---|---|---|
| `Rf`, nimiväärtus 10 kΩ | A15 | A18 | Negatiivne tagasiside |
| Juhe | B15 | C26 | `Rf` esimene ots A väljundile |
| Juhe | B18 | C27 | `Rf` teine ots A− sisendile |
| 2 kΩ takisti nr 1 | I33 | I36 | `Rref` ahela esimene osa |
| 2 kΩ takisti nr 2 | G36 | G39 | `Rref` ahela teine osa |
| 2 kΩ takisti nr 3 | I39 | I42 | `Rref` ahela kolmas osa |
| Juhe | J27 | J33 | Puhverdatud `Vref` takistiahelasse |
| Juhe | J42 | A27 | Takistiahela teine ots A− sisendile |

G36 ja I36 on ühendatud sama rea kaudu, samuti G39 ja I39. Nii tekib
jadaühendus, mitte kolm paralleelset takistit. Mõõdetud `Rf` ja kogu
`Rref` on kirjas [22.10 mõõtmistes](bench_session.md#takistuste-mõõtmised).
Kolme 2 kΩ nimiväärtuse summa ei asenda mõõdetud kogutakistust. Üksikute
takistite mõõdetud väärtusi allikas ei anna.

Sõlmede järgi ühendub `Vin` A+ sisendile; `Rf` ühendab A väljundi A−
sisendiga ja `Rref` ühendab sama A− sisendi puhverdatud viitega. See on
nihutatud mitteinverteeriv aste, mitte projekteerimislehe varasem sobitatud
nelja takistiga diferentsiaalvõimendi näide.

## 6. Mõõtmine ja arvutuse kontroll

22.10 mõõtis Maksim pinged ühise maa suhtes. Mõõtepunktid ja algsed näidud
on [bench_session.md tabelis](bench_session.md#22102026--lm358n-katseskeemi-mõõtmised-maksim):
must mõõteots D29, punane järjest H26, C28, C27, J27 ja C26.
A− ning A+ vahe oli 1 mV; see sobib negatiivse tagasiside ootusega selles
tööpunktis, kuid ei tõesta kogu vahemiku lineaarsust.

Ideaalse astme võrrand on `Vout = (1 + Rf/Rref) × Vin − (Rf/Rref) × Vref`.
Mõõdetud takistustega saab `Vout ≈ 2,542 × Vin − 1,542 × Vref`.
[Arvutusleht](opamp_design.md#väljundpinge-arvutamine) näitab asendust:
`Vin = 0,402 V`, `Vref = 0,520 V`, arvutatud väljund ligikaudu `0,220 V`,
mõõdetud väljund `0,205 V`. Märgiga viga on ligikaudu `−15 mV`
(`mõõdetud − arvutatud`); algallika 15 mV on erinevuse suurus.
Ühte kindlat vea põhjust ei ole tuvastatud. Neid koefitsiente ei kasutata
rõhu- ega ADC kalibratsioonina.

Pärast B5K muutmist mõõtis Maksim väljundil 3,009 V. Selle punkti `Vin`
jäi salvestamata; seda ei saa kasutada täpse võimenduse kontrolliks.

## 7. G5 ühenduse ajalugu ja järgmise katse piir

Algallika järgi ühendas Maksim pärast väljundi kontrolli A26 → AtomS3R G5,
eemaldas enne ühendamist USB-toite ja ühendas USB seejärel tagasi.
A26 on sama sõlm kui E26 ehk LM358 A väljund. ADC programmi ta selles
22.10 katses ei käivitanud. See on ajalooline ühendusfakt, mitte kinnitatud
ADC mõõtmine või luba ühendus praegu taastada.

**3,009 V ei kinnita G5 jaoks kogu reguleerimisvahemiku ohutust.** Enne uut
pingestamist jäta G5 lahti ja kontrolli kogu väljundulatust, käivitumise
ning lülituste siirdeid ja konkreetse ADC lubatud sisendit. Vajadusel
arvuta ning kontrolli sisendikaitse õpetajaga. LM358 5 V toide ja 1 kΩ
potentsiomeetrite jadatakisti ei taga G5 kaitset.
[Elektriline tööjärjekord](bench_session.md#elektriline-kontroll-enne-g5-ühendamist)
kehtib ka selle katseskeemi uuesti kasutamisel.

## 8. Kaitsmiseks veel vajalik

- MPX5700AP tegelik toide ja väljundid atmosfääril, imemisel ning puhumisel.
- Anduri vahemikust lähtuv lõplik aste, esimese ja parandatud versiooni kontroll.
- G5 elektriline sobivus, ADC/pinge/rõhu kalibratsioon ja päris ajatemplitega CSV.
- Samade impulsside `raw/opamp` kordused, ostsillogrammid, spektrid ja SNR.
- Pumbajuhtimise ning pooliku haarde võrdlus; 22.10 katse neid ei kinnita.

Selle dokumentatsiooni avaldamine ei muuda püsivara ega tähenda kohaliku
AUTO-versiooni üleslaadimist või riistvaralist kinnitamist.
