Dennel04/data-acquisition-course/data-acquisition/lab1/data/lab1_ownbox_release_test_02.10.26.csv

t_ms | p_kpa | phase
447612 | 3.23246 | rest
447622 | 4.216255 | rest
447632 | 4.497337 | rest
447642 | 3.23246 | rest
447652 | 2.951385 | rest
447662 | 4.075706 | rest
447672 | 2.670303 | rest
447682 | 3.794624 | rest
447692 | 3.513542 | rest
447702 | 2.951385 | rest
447712 | 4.497337 | rest
447722 | 3.794624 | rest
447732 | 4.637886 | rest
447742 | 4.356781 | rest
447752 | 2.951385 | rest
447762 | 4.497337 | rest
447772 | 3.23246 | rest
447782 | 3.935173 | rest
447792 | 3.513542 | rest
447802 | 2.670303 | rest
447812 | 3.513542 | rest
447822 | 3.23246 | rest
447832 | 4.356781 | rest
447842 | 3.373016 | rest
447852 | 3.091911 | rest
447862 | 3.935173 | rest
447872 | 3.23246 | rest
447882 | 3.23246 | rest
447892 | 3.23246 | rest
447902 | 3.654076 | rest
447912 | 4.216255 | rest
447922 | 3.794624 | rest
447932 | 3.935173 | rest
447942 | 3.935173 | rest
447952 | 2.529755 | rest
447962 | 4.778412 | rest
447972 | 4.918968 | rest
447982 | 4.637886 | rest
447992 | 4.637886 | rest
448002 | 3.373016 | rest
448012 | 4.075706 | rest
448022 | 4.216255 | rest
448032 | 4.356781 | rest
448042 | 3.654076 | rest
448052 | 2.248672 | rest
448062 | 4.778412 | rest
448072 | 4.356781 | rest
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
