Dennel04/data-acquisition-course/data-acquisition/lab2/data/opamp_pressure_test.csv

t_ms | adc | p_kpa | pump | config | run_id | seq | missed | voltage_v | dmm_reference_v | dmm_recorded_utc | condition | trial | adc_clipped
1219018 | 663 |  |  | opamp | 718280cc95ad4ceb | 0 | 0 |  | 0.19 | 2026-10-25T07:28:32.232706+00:00 | test_signal | 1 | 0
1219028 | 661 |  |  | opamp | 718280cc95ad4ceb | 1 | 0 |  | 0.19 | 2026-10-25T07:28:32.232706+00:00 | test_signal | 1 | 0
1219038 | 661 |  |  | opamp | 718280cc95ad4ceb | 2 | 0 |  | 0.19 | 2026-10-25T07:28:32.232706+00:00 | test_signal | 1 | 0
1219048 | 665 |  |  | opamp | 718280cc95ad4ceb | 3 | 0 |  | 0.19 | 2026-10-25T07:28:32.232706+00:00 | test_signal | 1 | 0
1219058 | 663 |  |  | opamp | 718280cc95ad4ceb | 4 | 0 |  | 0.19 | 2026-10-25T07:28:32.232706+00:00 | test_signal | 1 | 0
1219068 | 665 |  |  | opamp | 718280cc95ad4ceb | 5 | 0 |  | 0.19 | 2026-10-25T07:28:32.232706+00:00 | test_signal | 1 | 0
1219078 | 667 |  |  | opamp | 718280cc95ad4ceb | 6 | 0 |  | 0.19 | 2026-10-25T07:28:32.232706+00:00 | test_signal | 1 | 0
1219088 | 665 |  |  | opamp | 718280cc95ad4ceb | 7 | 0 |  | 0.19 | 2026-10-25T07:28:32.232706+00:00 | test_signal | 1 | 0
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
