Dennel04/data-acquisition-course/data-acquisition/lab2/data/opamp_pump_off_test.csv

t_ms | adc | p_kpa | pump | config | run_id | seq | missed | voltage_v | dmm_reference_v | dmm_recorded_utc | condition | trial | adc_clipped
1001106 | 664 |  |  | opamp | 9892664b79164223 | 0 | 0 |  | 0.19 | 2026-10-25T07:24:54.324400+00:00 | test_signal | 1 | 0
1001116 | 659 |  |  | opamp | 9892664b79164223 | 1 | 0 |  | 0.19 | 2026-10-25T07:24:54.324400+00:00 | test_signal | 1 | 0
1001126 | 661 |  |  | opamp | 9892664b79164223 | 2 | 0 |  | 0.19 | 2026-10-25T07:24:54.324400+00:00 | test_signal | 1 | 0
1001136 | 658 |  |  | opamp | 9892664b79164223 | 3 | 0 |  | 0.19 | 2026-10-25T07:24:54.324400+00:00 | test_signal | 1 | 0
1001146 | 662 |  |  | opamp | 9892664b79164223 | 4 | 0 |  | 0.19 | 2026-10-25T07:24:54.324400+00:00 | test_signal | 1 | 0
1001156 | 662 |  |  | opamp | 9892664b79164223 | 5 | 0 |  | 0.19 | 2026-10-25T07:24:54.324400+00:00 | test_signal | 1 | 0
1001166 | 662 |  |  | opamp | 9892664b79164223 | 6 | 0 |  | 0.19 | 2026-10-25T07:24:54.324400+00:00 | test_signal | 1 | 0
1001176 | 661 |  |  | opamp | 9892664b79164223 | 7 | 0 |  | 0.19 | 2026-10-25T07:24:54.324400+00:00 | test_signal | 1 | 0
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
