Dennel04/data-acquisition-course/data-acquisition/lab2/data/opamp_test_off_ver2.csv

t_ms | adc | p_kpa | pump | config | run_id | seq | missed | voltage_v | dmm_reference_v | dmm_recorded_utc | condition | trial | adc_clipped
684627 | 539 |  |  | opamp | 04fa53f1b1eb41ff | 0 | 0 |  | 0.19 | 2026-10-25T12:26:58.891438+00:00 | test_signal | 1 | 0
684637 | 539 |  |  | opamp | 04fa53f1b1eb41ff | 1 | 0 |  | 0.19 | 2026-10-25T12:26:58.891438+00:00 | test_signal | 1 | 0
684647 | 544 |  |  | opamp | 04fa53f1b1eb41ff | 2 | 0 |  | 0.19 | 2026-10-25T12:26:58.891438+00:00 | test_signal | 1 | 0
684657 | 543 |  |  | opamp | 04fa53f1b1eb41ff | 3 | 0 |  | 0.19 | 2026-10-25T12:26:58.891438+00:00 | test_signal | 1 | 0
684667 | 546 |  |  | opamp | 04fa53f1b1eb41ff | 4 | 0 |  | 0.19 | 2026-10-25T12:26:58.891438+00:00 | test_signal | 1 | 0
684677 | 542 |  |  | opamp | 04fa53f1b1eb41ff | 5 | 0 |  | 0.19 | 2026-10-25T12:26:58.891438+00:00 | test_signal | 1 | 0
684687 | 549 |  |  | opamp | 04fa53f1b1eb41ff | 6 | 0 |  | 0.19 | 2026-10-25T12:26:58.891438+00:00 | test_signal | 1 | 0
684697 | 540 |  |  | opamp | 04fa53f1b1eb41ff | 7 | 0 |  | 0.19 | 2026-10-25T12:26:58.891438+00:00 | test_signal | 1 | 0
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
