Dennel04/data-acquisition-course/data-acquisition/lab2/data/opamp_test_pressure_ver3.csv

t_ms | adc | p_kpa | pump | config | run_id | seq | missed | voltage_v | dmm_reference_v | dmm_recorded_utc | condition | trial | adc_clipped
771939 | 821 |  |  | opamp | 798adb4a23574669 | 0 | 0 |  | 0.19 | 2026-10-25T12:28:26.202919+00:00 | test_signal | 1 | 0
771949 | 804 |  |  | opamp | 798adb4a23574669 | 1 | 0 |  | 0.19 | 2026-10-25T12:28:26.202919+00:00 | test_signal | 1 | 0
771959 | 806 |  |  | opamp | 798adb4a23574669 | 2 | 0 |  | 0.19 | 2026-10-25T12:28:26.202919+00:00 | test_signal | 1 | 0
771969 | 790 |  |  | opamp | 798adb4a23574669 | 3 | 0 |  | 0.19 | 2026-10-25T12:28:26.202919+00:00 | test_signal | 1 | 0
771979 | 794 |  |  | opamp | 798adb4a23574669 | 4 | 0 |  | 0.19 | 2026-10-25T12:28:26.202919+00:00 | test_signal | 1 | 0
771989 | 818 |  |  | opamp | 798adb4a23574669 | 5 | 0 |  | 0.19 | 2026-10-25T12:28:26.202919+00:00 | test_signal | 1 | 0
771999 | 822 |  |  | opamp | 798adb4a23574669 | 6 | 0 |  | 0.19 | 2026-10-25T12:28:26.202919+00:00 | test_signal | 1 | 0
772009 | 813 |  |  | opamp | 798adb4a23574669 | 7 | 0 |  | 0.19 | 2026-10-25T12:28:26.202919+00:00 | test_signal | 1 | 0
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
