Dennel04/data-acquisition-course/data-acquisition/lab2/data/opamp_test_vacum_ver3.csv

t_ms | adc | p_kpa | pump | config | run_id | seq | missed | voltage_v | dmm_reference_v | dmm_recorded_utc | condition | trial | adc_clipped
804838 | 461 |  |  | opamp | 888b03f20fc34c3c | 0 | 0 |  | 0.19 | 2026-10-25T12:28:59.101178+00:00 | test_signal | 1 | 0
804848 | 462 |  |  | opamp | 888b03f20fc34c3c | 1 | 0 |  | 0.19 | 2026-10-25T12:28:59.101178+00:00 | test_signal | 1 | 0
804858 | 465 |  |  | opamp | 888b03f20fc34c3c | 2 | 0 |  | 0.19 | 2026-10-25T12:28:59.101178+00:00 | test_signal | 1 | 0
804868 | 468 |  |  | opamp | 888b03f20fc34c3c | 3 | 0 |  | 0.19 | 2026-10-25T12:28:59.101178+00:00 | test_signal | 1 | 0
804878 | 461 |  |  | opamp | 888b03f20fc34c3c | 4 | 0 |  | 0.19 | 2026-10-25T12:28:59.101178+00:00 | test_signal | 1 | 0
804888 | 458 |  |  | opamp | 888b03f20fc34c3c | 5 | 0 |  | 0.19 | 2026-10-25T12:28:59.101178+00:00 | test_signal | 1 | 0
804898 | 464 |  |  | opamp | 888b03f20fc34c3c | 6 | 0 |  | 0.19 | 2026-10-25T12:28:59.101178+00:00 | test_signal | 1 | 0
804908 | 471 |  |  | opamp | 888b03f20fc34c3c | 7 | 0 |  | 0.19 | 2026-10-25T12:28:59.101178+00:00 | test_signal | 1 | 0
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
