Dennel04/data-acquisition-course/(commit log)

2026-09-12 Add Lab 1 working firmware/logger: Stage A sanity check, full firmware, Python logger
    - firmware_stageA_sanity/: bare ADC-on-G5-to-Serial bring-up test (PlatformIO,
    m5stack-atoms3 / AtomS3(R))
    - firmware/: sensor.h/.cpp (ADC + MPX5700AP transfer function),
    pump_logic.h/.cpp (suction/blow hysteresis state machine), comms.h/.cpp
    (JSON wire protocol), main.cpp (10ms non-blocking loop)
    - python/logger.py: reads Atom's JSON telemetry, writes CSV, sends
    mode/band commands, drives MG400 pump box via mg400-base HTTP API,
    500ms watchdog
    - BUILD_NOTES.md: what's verified vs. still needs bench measurement,
    suggested working order
2026-09-12 Stage A: add on-screen alive status (M5Unified), verified against Serial CSV
    Not part of the graded part-2 check (that's still the Serial CSV vs.
    multimeter) -- just a convenience readout (raw/volts/sample counter with
    a blinking marker) so it's obvious the board booted and is still
    sampling without keeping the serial monitor open. Confirmed on hardware:
    screen values track the Serial CSV, counter/marker updating live.
2026-09-12 Lab1: measured ADC reference, fix screen flicker, fill dev journal
    - sensor_choice.md: document 12.09.26 wiring debug (bad GND contact,
    sensor reversed), Vout=0.85V vs naive ADC 0.758V (~11% gap), backed
    out V_ref~=3.70V.
    - sensor.cpp: adcReferenceVolts() updated from 3.3V placeholder to the
    measured 3.70V.
    - main.cpp: fix visible screen flicker by drawing into an M5Canvas
    off-screen sprite and pushSprite()-ing the whole frame in one SPI
    transfer, instead of fillScreen()+printf() straight to the panel.
    Also decouple the on-screen refresh (150ms) from the 10ms sensor/JSON
    cadence, and bump text size for readability (1 -> 1.5).
    - README.md: check off/annotate checklist items with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
    [main.cpp, sensor.cpp]
2026-09-12 Lab1: log ACU2-B smart box (part 3), pump_control.md, Pa/step calc
    - docs/pump_control.md (new): part 3 result -- ACU2-B logged 5.97min via
    a single suck command + hands-off logger.py run. Cut-out pressure
    ~-91.5kPa confirmed; cut-in not triggered in this window (seal held,
    no leak-back cycle) -- documented as a valid result, not an error.
    - data/lab1_smartbox_acu2b_12.09.26.csv (new): raw log backing the above,
    35800 rows / 358.0s, ~100Hz confirmed.
    - docs/sensor_choice.md: add the Pa-per-ADC-step calculation (measured
    V_ref=3.70V gives ~141 Pa/step vs the README's nominal ~125 Pa/step
    assumption).
    - README.md: check off the MPX5700AP+kPa+CSV and smart-box-log checklist
    items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
    [lab1_smartbox_acu2b_12.09.26.csv]
2026-09-12 Lab1: part 4 holding-curve scenario 1 (napp klaasil, own box)
    - docs/pump_control.md: own MG400 pump box, glass scenario -- vacuum
    pulled to -83.06kPa (~12-16s), then manually switched off at the peak
    and left alone; leaked back to atmosphere (>=-2kPa) in 310.7s (~5.18
    min). First full leak curve (unlike ACU2-B's lower-bound-only result).
    - data/lab1_ownbox_glass_12.09.26.csv: raw log backing the above (39829
    rows / 398.3s, ~100Hz confirmed).
    - README.md: dev journal entry for the mg400-base web UI setup (found
    and explained the "Sync sliders" red herring -- real issue was Enable
    never pressed, so servo_active stayed false) plus this test session;
    progress note added to the "Si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
    [lab1_ownbox_glass_12.09.26.csv]
2026-09-12 Lab1: part 4 holding-curve scenario 2 (napp õhus, own box)
    Suction cup left in open air (no seal at all). Pump could only pull to
    a noisy -12..-15kPa plateau (vs -83kPa sealed on glass) before being
    switched off; recovered to atmosphere in 17.0s (vs 310.7s for glass).
    Confirms the cup/surface contact -- not the pump/valve -- dominates the
    system's leak rate. Raw log: data/lab1_ownbox_air_12.09.26.csv (9376
    rows, 93.75s).
    [lab1_ownbox_air_12.09.26.csv]
2026-09-12 Lab1: part 4 holding-curve scenario 3 (voolik korgiga) + full comparison
    - docs/pump_control.md: capped-tube scenario -- max vacuum -83.34kPa
    (matches the glass scenario almost exactly), near-zero loss for ~30s,
    then one sharp step down to a -58..-60kPa plateau (likely a minor
    accidental bump, not a real leak characteristic -- team confirmed
    nothing was deliberately touched), stable for 240s+ after. Added a
    full 3-scenario comparison table and conclusion: system leak rate is
    dominated by the cup/surface contact, not the pump/tubing/valves.
    - data/lab1_ownbox_capped_12.09.26.csv: raw log (31193 rows, 311.9s).
    - README.md: dev journal entry for this session, checklist item updated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
    [lab1_ownbox_capped_12.09.26.csv]
2026-09-13 Lab1: part 2 verification (2% ADC check, 100Hz rate, LSB noise, Falstad noise sim)
    - ADC vs multimeter check with measured V_ref=3.70V: ~0.5% diff, passes
    README's <=2% requirement (vs ~10.4% at nominal 3.3V).
    - Logging rate check: 1002 JSON lines in a 10.01s window, passes 1000+-5.
    - LSB noise, pump off vs pump on: atmosphere baseline 941.6 ADC (std 4.84
    LSB) vs held vacuum via physical pump button 361.1 ADC (~-81.7 kPa,
    std 3.68 LSB), transition ~190ms. Noted first attempt via mg400-base
    HTTP API gave no real pressure change (loose connection or wrong DO
    guess) and noise being lower during held vacuum than idle (valve holds
    passively, motor not continuously running) -- document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
    [lab1_lsb_noise_vacuum_button_13.09.26.csv]
2026-09-13 Lab1: part 1 sensor comparison, bom.md (null result), oscilloscope spectrum attempt
    - docs/sensor_choice.md: part 1 sensor comparison table (MPX5700AP vs
    MPX4250AP vs MPX5100GP+MPXV6115V) with real NXP datasheet numbers --
    sensitivity, Pa/ADC-step, % scale used, output voltage in our -70..+110
    kPa window. Decision: keep MPX5700AP -- all three alternatives give
    better resolution but their output exceeds the ESP32 ADC's safe ~3.3V
    input in our operating range, and a divider/op-amp isn't allowed yet
    (part 2 constraint). Sources cited.
    - docs/bom.md: checked the shelf against part 1's findings -- everything
    needed was already on hand, no Mouser order was actually necessary this
    r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
2026-09-13 Lab1: document recurring switching-transient noise finding (oscilloscope)
    At 500ns/div, CH1 (AC, 100mV/div) showed a sharp microsecond-scale
    zigzag transient recurring in ~7 of the observed trigger frames while
    the pump ran, absent when it's off -- consistent with switching noise
    from the valve/motor commutation rather than the slow (~100-200ms)
    pressure change itself. Exact repetition frequency not measured (scale
    didn't allow it), but the on/off recurrence is a real, honest
    source-confirmed finding for part 2's spectrum requirement.
2026-09-13 Lab1: part 4 -- pick real on/off band from the three holding curves
    Computed threshold-crossing times directly from the three CSVs
    (data/lab1_ownbox_{glass,air,capped}_12.09.26.csv) rather than eyeballing:
    - off-kPa = -75, on-kPa = -40, min-off-time = 15s, max-cycles/min = 4
    - -75kPa is physically unreachable in the "napp õhus" (open air) scenario
    (max there is only -15.46kPa) -- this alone prevents short-cycling in
    that case, satisfying the assignment's explicit worry, without relying
    on the min-off-time floor to do that work.
    - On glass, next restart only happens ~102s after peak; with the capped
    tube it never restarts within the logged window -- both far below the
    4/min ceiling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
2026-09-13 Lab1: wire up safety limits end-to-end, run real autonomous pump test
    Found and fixed a real gap before running part 4's autonomous test:
    logger.py accepted --min-off-ms/--max-cycles-per-min but never sent them
    to the firmware, and main.cpp never called setSafetyLimits() -- so the
    short-cycle/cycle-count protection existed only as unused code in
    pump_logic.h. Added a new wire-protocol command
    {"cmd":"limits","minOffMs":...,"maxCyclesPerMin":...} (comms.h/.cpp parse
    it, main.cpp applies it via setSafetyLimits()), logger.py now sends it at
    startup alongside band/mode. Recompiled and reflashed the Atom (COM6)
    before testing.
    Ran logger.py without --dry-run for the first time: Atom's own firmwa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
    [lab1_autonomous_run_13.09.26.csv]
2026-09-13 Lab1: clarify the leak was a test-setup artifact, not a real system leak
    Retested by actually lifting the glass with suction (a real pick) instead
    of pressing the cup against the glass flat on the table (as the earlier
    autonomous run did). Pressure held rock-steady at -76..-79kPa for a full
    30s with no sign of leak-back -- confirms the tubing/tee/gripper are
    airtight and the earlier fast decay was just an imperfect cup-to-table-glass
    contact, not a real plumbing leak. No band change needed for the ten-pick
    test.
2026-09-13 Lab1: add honest caveat -- 30s lift test isn't yet the full ACU2-B comparison
    The 30s stable-vacuum result (glass lifted by suction) disproves the
    "leak in the tee/gripper" hypothesis, but it's only ~8% of ACU2-B's
    ~6-minute part-3 test duration -- not yet grounds to claim the box holds
    as long as the smart box. Documented as an open next step (repeat with a
    multi-minute log) rather than letting the 30s result overstate the claim.
2026-10-02 Lab1: pick-cycle runner, run analyzer, USB-loss = pump off in logger
    logger.py: on Windows an unplugged USB raises SerialException from
    readline(), so the 500 ms watchdog never ran and the pump stayed on.
    Now the pump is forced off. Non-telemetry lines (letter) are skipped.
    pick_cycles.py: ten robot picks with the Atom deciding the pump.
    analyze_run.py: starts/min, run/idle times, duty cycle per run and cycle.
    [analyze_run.py, logger.py, pick_cycles.py]
2026-10-02 Open the Atom's serial without resetting it; warn on a bad zero
    pyserial's default open/close toggles DTR/RTS, which resets the
    ESP32-S3 over native USB. Each reset re-took the atmospheric zero from
    whatever was in the tube: with the glass held at -62 kPa a reconnect
    made it read 0 kPa (seen 02.10.26). open_atom() sets DTR/RTS low before
    open(); check_zero() warns if the Atom just booted or reads >3 kPa at rest.
    [logger.py, pick_cycles.py]
2026-10-02 Stored atmospheric zero in firmware, watchdog thread, hold test
    firmware: the zero was re-taken at every boot, and opening the USB port
    reboots the Atom -- a reconnect with the glass held at -62 kPa made -62
    read as 0. MPX5700AP is absolute, so keep the last good zero in NVS; a
    boot reading only replaces it within 2 kPa (weather), {"cmd":"zero"}
    only with the pump off and near atmosphere.
    logger: the 500 ms watchdog ran inside the read loop and waited when an
    unplugged USB hung readline() (pump off 1.6 s after the last line); now
    its own thread (495 ms measured with a stalled loop). --zero flag.
    hold_test.py: grip with the pump forced on, lift, Atom band holds.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
    [comms.cpp, comms.h, hold_test.py, logger.py, main.cpp, pick_cycles.py, zero.cpp, zero.h]
2026-10-02 Lab1 data 02.10.26: glass lift/hold runs, release test, USB unplug test
    [lab1_ownbox_glass_lift_02.10.26.csv, lab1_ownbox_glass_lift_band60_02.10.26.csv, lab1_ownbox_hold_air_02.10.26.csv, lab1_ownbox_hold_air_02.10.26.events.csv, lab1_ownbox_release_test_02.10.26.csv, lab1_usb_unplug_02.10.26.csv]
2026-10-02 Pump HTTP off the read path; 127.0.0.1; fw2 test logs
    The read loop made the pump HTTP call itself and waited 0.2-1 s, so the
    Atom went unread and the watchdog kept forcing the pump off. A sender
    thread now posts the newest wanted state; set_mode() returns in 0.01 ms.
    localhost -> 127.0.0.1 (Windows tried IPv6 first: 210 ms -> 1.2 ms).
    Results 02.10.26 with the stored-zero firmware: 60 s hold in the air
    -81 -> -57 kPa with no restart (duty 6.9 %); Atom reboot with -67 kPa
    in the tube kept the reading (stored zero); USB unplug: pump off 29 ms
    after the last line (was 1.6 s).
    [lab1_ownbox_hold_air_fw2_02.10.26.csv, lab1_ownbox_hold_air_fw2_02.10.26.events.csv, lab1_usb_unplug_fw2_02.10.26.csv]
2026-10-02 Commanded starts bypass the motor limits; 10-pick in-place runner
    pump_logic: min-off-time and the starts/min cap applied to every start,
    so a release blow 6.7 s after a band stop and the 3rd grip in a minute
    were refused (first 10-pick run stopped at cycle 3). Like the smart box,
    a mode change from the PC now starts at once; the limits only govern the
    band's automatic restarts, and only those are counted.
    pick_in_place.py: N picks in one spot, never below the start Z (floor),
    sets the glass down with the pump on before stopping on an error.
    [lab1_pick10_02.10.26.csv, lab1_pick10_02.10.26.events.csv]
2026-10-02 Lab1 data 02.10.26: 10/10 glass picks with the Atom deciding the pump
    [lab1_pick10_fw3_02.10.26.csv, lab1_pick10_fw3_02.10.26.events.csv]
2026-10-02 approach_and_grip: lower, vacuum on just above the floor, stop on the seal
    grip.py: normal speed to floor + pump_on_mm, vacuum on (commanded start),
    creep at 2 % with a 0.3 s ramp while reading the pressure every 10 ms;
    p <= seal_kpa stops the arm at the contact Z; the Atom's band then stops
    the pump at off_kpa (attached). Floor reached with no seal -> pump off,
    'no piece'. Never below the floor. pick_in_place.py --approach uses it
    each cycle; the error set-down now only runs when the glass is lifted.
    Simulator: seal found 0.5 mm past the glass top, attached at -60 kPa,
    2/2 picks; with no glass it stops at the floor with the pump off.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
    [grip.py, pick_cycles.py, pick_in_place.py]
2026-10-02 approach_and_grip: attached = the Atom stopped the pump and the vacuum holds
    The tube settles a few kPa weaker right after the Atom's stop (-60 ->
    -55 and holds), so requiring <= off+2 failed a good grip. Now: pump went
    off by the Atom's decision and p stays stronger than on_kpa.
    Robot run 02.10.26, --approach, 10 cycles: 10/10 picks, contact found at
    Z -102.8..-103.0 (floor -105), 0.67-0.73 s after vacuum on, pump stopped
    at -54..-65 kPa; duty 29 % (45 % with the forced-on grip).
    [lab1_approach_02.10.26.csv, lab1_approach_02.10.26.events.csv, lab1_approach_pick10_02.10.26.csv, lab1_approach_pick10_02.10.26.events.csv]
2026-10-02 Lab1: 02.10.26 results in pump_control.md + README, simulator, build notes
    pump_control.md: full 02.10.26 section -- fixes that made the numbers
    honest, every test with its CSV, the five numbers (band -60/-40, 15 s,
    4/min automatic only, duty 45 % / 29 % over 10 picks), blow: no hose cap
    needed (team decision; blow is the 0.5 s release pulse, checked 20x).
    README checklist: dated 02.10.26 notes under 'Sinu kast'.
    src/python/sim: fake MG400 + Atom bench with portable paths.
2026-10-03 logger.py --station: forward Atom letter lines to the Smart Solutions station
    Merged Atom firmware sends letters on the same USB line as telemetry; the
    lab PC has no WiFi. POSTs run on their own thread so the 500 ms watchdog is
    never starved.
2026-10-06 Update README with lab session details and participants
    Updated participant information and detailed the activities and observations from the lab session, including the setup and issues encountered with the circuit.
2026-10-08 lab1: oscilloscope photos (bench setup, FFT 13.09.26) in part 2 and sensor_choice.md
2026-10-23 docs(lab2): document LM358N wiring and measured circuit behavior
2026-10-23 docs(lab2): clarify defense date and shared board firmware
2026-10-24 docs: add Lab 2 Oct 24 ADC test log
2026-10-25 docs(lab2): document op-amp v2 rebuild and handoff to Maksim
    Records the Oct 25 breadboard changes made after the divider runs:
    B5K removed, Rref extended with two 1 kOhm in series (J42 -> A22 -> A-),
    bottom 10 kOhm divider resistor removed, 4.7 kOhm pull-down added on the
    Vref buffer output. Includes measured J27 minimum before/after the
    pull-down (0.675 V -> 0.35 V), the LM358 output sink-current explanation,
    analysis of the three divider CSVs (vacuum clipping, ADC/DMM agreement,
    stale metadata), open TODOs and next steps. Links it from the README.
2026-10-25 Document Oct 25 pressure measurements
2026-11-06 lab2: add software-tested AUTO ADC preview and logger support
2026-11-07 docs(lab3): sync UV BOM and shared actuator software status
2026-11-13 lab3: drop plate (4x4 Gridfinity, 5x5 drops, 0.6 mm spacer pads) and AtomS3 screen-side mock, Fusion source, STL, 3MF
2026-11-13 lab3: drop plate printer files (bed 1 printing, bed 2 to print) + PRINT.md for the team (EST/RU)
2026-11-13 docs(lab3): improve defense guide and integrate CAD evidence
2026-11-14 Add Lab 2 pressure test data
2026-11-14 docs(lab3): add plate measurements and original V1 files
2026-11-14 DA lab3: second V2 drop plate printed, pad height 0.6 mm
2026-11-14 DA lab3: plate 2 size 167.5, Gridfinity stable, cover glass loose between posts
2026-11-14 DA lab3: cover glass measured 29.65-29.7 mm, slides between rows
2026-11-14 DA lab3: drop plate V3 design (plus-shaped stops, pocket for 29.65 glass), script, not printed
2026-11-14 DA lab3: drop plate V3 exported (f3d, STL, bgcode 2h52m)
2026-11-14 docs(lab2): 14.11 op-amp fault finding, rebuild plan and G5 meter firmware
    - opamp_rebuild_2026-11-14.md: Raimo's measurements on the v2 board
    (sensor output stuck at ~0.5 V on the board, 5 V supply and syringe
    seal confirmed, sensor works off the board), conclusion that the old
    breadboard connections are faulty, new board layout and build order.
    - src/firmware_g5meter: temporary AtomS3R firmware that shows G5 volts and
    MPX5700AP kPa on the LCD; now on the shared Atom. DA2_MEASURE_V1 was
    backed up (full 8 MB flash) before upload; the image stays off the repo.
    - Dated 14.11.26 notes under the existing lines in README.md,
    opamp_v2_handoff_2026-10-25.md and src/README.md. No old tex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
2026-11-14 docs(lab2): add measured sensor range and revised rebuild plan (14.11)
    Sensor alone on the new board: 0.32 V full suction, 0.831 V atmosphere,
    2.40 V full blowing. The plan changes to fit that range: B100K with a
    47k/10k attenuator for Vref (0-0.88 V), Rref 6.8k + 47k (A ~1.19,
    Vref ~0.43 V, Vout ~0.30-2.77 V), 0.1 uF at G5, and the real hole
    positions (sensor J1-J6, Atom plugged in at D62/D63/H60, pot J34-J38).
    Dated corrections under the earlier plan; nothing removed.
2026-11-14 lab2: guided op-amp retest for the rebuilt stage (no B5K)
    - src/python/opamp_retest.py: finds the Atom port, detects the firmware
    (DA2_MEASURE_V1 via logger.py at 100 Hz in the official CSV schema, or
    the G5 meter as fallback), records atmosphere / full suction / full
    blowing holds and writes PASS/WARN/FAIL checks to REPORT.md and
    summary.json under lab2/data/opamp_retest_<date>/.
    - run_opamp_retest.bat / .command: double-click launchers that create
    .venv on first run.
    - tests/test_opamp_retest.py: 11 offline tests (synthetic data, mocks).
    - docs/opamp_retest.md and a dated note in src/README.md.
2026-11-14 data(lab2): op-amp retest results 14.11 (final 17:47 PASS)
    Four completed runs of opamp_retest.py on the rebuilt stage (G5 meter
    firmware, COM4): 17:37 FAIL (flat 0.847 V), 17:40 FAIL (blowing only
    1.13 V), 17:45 PASS (late suction), 17:47 PASS (0.236 / 0.858 / 2.664 V,
    gain 1.168). Dated note added to opamp_rebuild_2026-11-14.md.
